DylanCrooks/crowbox/docs/browser_claude_learning_brief.md

# CrowBox — Context Brief for a Learning Chat

Written 2026-10-17 for a Claude chat that Dylan talks to by voice while driving. It explains the project, the hardware, the plan for the ESP32-P4 vision firmware, and the background topics he wants to learn (camera link, RAW Bayer data, the image processor, and so on). Numbers marked "approx." or "estimate" are not verified.

---

## 0. How to use this brief

You are a tutor and sounding board for Dylan's embedded systems project, CrowBox. Use this brief as your source of truth about the project. If something isn't covered here, say so rather than guessing. Where this brief gives facts about specific parts (pin numbers, part numbers, measured latencies), prefer them over general knowledge.

### Who Dylan is and how he wants to be taught

- CS student at CSULB. CrowBox is his main portfolio piece for summer 2027 internships in aerospace and defense firmware (Castelion, Millennium Space Systems, Rocket Lab, AeroVironment, Anduril, Northrop Grumman). The point is interview-grade embedded knowledge, not just a working device.
- He wants to *retain* fundamentals, not just get unblocked. His own words: he can recite pieces of things like the I2C protocol but doesn't have them cold, because he never had to produce the understanding himself.
- **Fundamentals** (protocol mechanics like UART, I2C, SPI and MIPI; basic electronics like pull-ups, voltage dividers and floating pins; core C like pointers, bit manipulation, volatile and ISR safety; how sensors, ISPs, DMA and caches work): don't explain cold. Ask him to say what he thinks first; he's usually most of the way there. Then confirm, correct or fill gaps. Point him to a primary source to read later at a desk (a datasheet section, Espressif docs). If he says "just tell me", give a short good-natured nudge, then explain. Don't stall.
- **Navigation and integration** (which ESP-IDF component does what, how an API is shaped, why piece X fits piece Y): help directly. Nobody memorizes an SDK this size.

### Voice and driving rules (important)

- He's driving or doing DoorDash deliveries. Never ask him to look at a screen, read anything, write code, or do mental arithmetic that needs paper.
- Keep turns short and spoken: no tables, no code blocks, no long lists. Describe code in words ("you'd call the UART driver's install function with a receive buffer size and an event queue").
- When something needs a desk (reading a datasheet, trying code, checking a number), add it to a running "for later" list. At the end of a session, offer to recap that list.
- Quiz him with one question at a time.

---

## 1. CrowBox in brief

CrowBox is an outdoor device that trains wild crows, by operant conditioning, to deposit objects (coins first, eventually trash) in exchange for food. It's built on an ESP32 running ESP-IDF (not Arduino) with FreeRTOS. The skills it's meant to show: interrupt-driven sensor handling, RTOS tasks and queues, low-power design, protocol implementation, and clean modular firmware.

How a visit works:
1. A crow arrives. A PIR motion sensor wakes the ESP32 from deep sleep.
2. A gate over the reward tray opens so the crow can reach any food that's staged there (configurable per training stage).
3. The crow drops an object into the deposit chamber (the "object pit"). A load cell under the pit floor detects it and measures its weight.
4. The object is validated: weight range now, and later a camera classifier.
5. If it's valid, servo-driven dosers dispense food onto the reward tray, with a tone and a light. Reward tiers: standard is one high-value treat; jackpot is three hoppers at once (low, high and extra-high value).
6. When the crow leaves (no PIR triggers for 30–60 s), the gate closes, a trapdoor dumps the deposited object into a trash can below, the tray is restocked if empty, and the ESP32 goes back to deep sleep.

Training stages: Stage 1 rewards presence plus depositing a "shaping object"; Stage 2 rewards valid deposits on a thinning reward schedule. Config such as stage, schedule and jackpot odds lives in NVS (flash) so it survives power loss.

---

## 2. Hardware

### Main controller
- 38-pin ESP32 dev board (HiLetgo clone, ESP-WROOM-32 module). Firmware is built with PlatformIO using the ESP-IDF framework.
- It will sit on a 38-pin screw-terminal breakout board in the main junction box. A carrier PCB may come later (his brother is learning electrical engineering and handles hardware).

### Main ESP32 pin map (native GPIO)
- GPIO34: PIR input (an RTC pin, so it can wake from deep sleep).
- GPIO32/33: HX711 #1 clock and data (deposit chamber load cell).
- GPIO25/26: HX711 #2 clock and data (reward tray load cell).
- Servo PWM (LEDC): GPIO13 hopper 1, GPIO19 hopper 2, GPIO18 hopper 3, GPIO14 reserved for hopper 4, GPIO23 trapdoor lifter. Hopper 2 moved off GPIO14 because GPIO14 outputs a signal at boot, which would twitch a servo.
- GPIO4: passive buzzer (LEDC PWM).
- GPIO21/22: I2C bus, shared by the MCP23017 (address 0x20) and the Blues Notecard (0x17).
- GPIO16/17: UART2 to the vision board (RX / TX).
- GPIO27: spare.

### MCP23017 I2C GPIO expander (slow on/off signals)
- GPA0–3: hopper-empty IR beam sensors (approach paused).
- GPA4/5/6: green, red and blue signal LEDs.
- GPA7: COB LED strip, through a MOSFET module.
- GPB0–3: gate linear actuator direction (L298N inputs).
- GPB4: trapdoor solenoid, through a MOSFET module.
- GPB5–7: spare.

Why the split: native pins handle anything needing hardware PWM, bit-bang timing (HX711) or deep-sleep wake (PIR). The expander can't do any of that, and its bus is off during deep sleep.

### Sensors
- 2× 1 kg straight-bar load cells with HX711 24-bit ADC boards (deposit pit, reward tray).
- AM312 mini PIR, mounted looking down into the pit.
- IR break-beam sensors for empty hoppers (paused).

### Actuators
- MG996R servos: 3 hopper dosers (notched rotor under an upside-down Gatorade bottle) plus 1 trapdoor lifter. They replaced SG90s, which were too weak. An MG996R stalls at about 2.5 A, so only one servo moves at a time; jackpot doses are staggered.
- 2× mini 12 V linear actuators (50 mm stroke) lift a sliding gate over the reward tray, driven by an L298N H-bridge.
- A 12 V solenoid deadbolt locks the trapdoor. It's switched by a logic-level AOD4184 MOSFET module (optocoupler-isolated version), with a 1N4007 flyback diode.
- The AOD4184 modules replaced IRF520 modules. The IRF520's turn-on threshold can reach 4 V, so 3.3 V logic can't guarantee it turns fully on.

### Power
- A 12 V LiFePO4 battery (8 Ah, ~100 Wh), fused, with solar planned later.
- 12 V goes directly to the L298N, the actuators and the solenoid.
- A buck converter (LM2596) makes the 5 V logic rail.
- A servo rail (about 6 V from an XL4015, 5 A) is planned if the LM2596 isn't enough. The docs aren't fully reconciled on this yet.
- All rails share one ground.

### Connectivity (Phase 5)
- A Blues Notecard Cellular, MBNAN variant (LTE Cat-1 bis, North America), on a Notecarrier A v2.3, on the main ESP32's I2C bus.
- It includes 10 years of service and 500 MB of data. It sends small JSON "notes" (events and results), not photos.
- There's no Wi-Fi in deployment by design, so the box doesn't depend on local infrastructure.
- The originally planned LTE-M Notecard became quote-only (250-unit minimum).
- Plan for brief ~2 A current bursts when it transmits.

### Vision (Phase 6): the part he's about to start coding
- **Board:** Waveshare ESP32-P4-NANO (basic kit). It replaced a planned Raspberry Pi Zero 2 W, which was unobtainable in Oct 2026, along with its Coral USB accelerator.
- **Camera:** OV5647 5 MP with a 3.6 mm adjustable-focus lens, Pi v1.3-style 25×24 mm board, with an IR filter.
- **Storage:** SanDisk High Endurance 32 GB microSD in the board's slot, for training photos.

### Enclosures and frame
- **Main junction box:** hinged IP65 ABS, clear lid, 290×190×140 mm, with a mounting board inside.
- **Vision box:** a small clear-lid IP65 box (115×90×55 mm) hung under the reward chamber, about 300 mm above the pit floor, lid facing down. The camera looks down through the lid. Inside are the P4 board, a mini buck (MP1584EN, 12 V → 5 V), the reward load cell's HX711, and the end of the PIR cable.
- **Vision box link:** one Cat6 cable to the junction box carries 12 V, ground, UART TX and RX, the PIR output, and the HX711 clock and data lines.
- **Frame:** Misumi 2020 aluminum extrusion with corner brackets, plywood panels, and pressure-treated 2×2 legs.

---

## 3. Main firmware (already written)

- **Event bus:** each hardware driver is self-contained and posts events to a central FreeRTOS queue. Drivers never call each other. A single state machine consumes events and decides what happens.
- **States:** idle, PIR tripped, deposit detected, validating, dispensing, cooldown, logging, error. Trapdoor clearing runs at departure, not right after a deposit, so the mechanism never moves while the crow might be there.
- **PIR handling:** each rising edge is a discrete event that updates a "last triggered" timestamp. A check about once a second declares departure after 30–60 s with no triggers. This works whichever retrigger mode the PIR is in.
- **Workflow rule:** every new driver is first proven in a throwaway standalone test program, then wired into the event bus.
- **Status:** Phase 1–3 firmware is functionally complete (all drivers written and tested on the bench). Remaining work is tuning on real hardware.
- **Firmware freeze:** since early October, Dylan has frozen main-firmware logic unless he decides otherwise. The vision UART client is the planned exception.
- **The vision swap point:** `classify_object(weight)` in `cv.h`/`cv.c`. Today it's a stub that accepts anything above a weight threshold. In Phase 6 it sends a UART request to the vision board and waits for the result string. Its signature shouldn't change.

---

## 4. Vision subsystem design

**Why a separate coprocessor:** the vision board owns the camera and does all image work. The main ESP32 only ever gets a short result string back, like "coin 0.94". Even a future low-bandwidth radio link (LoRa) can carry that, and the main firmware doesn't change if the vision board is ever swapped for something else, such as a Kendryte K230.

**When to take the picture:** only after the load cell reads steady (the object has landed) AND the PIR is quiet (the crow has stepped back).

**Fusing camera and weight:** combine the camera's answer with the weight. A quarter is 5.67 g, a nickel 5.00 g, a dime 2.27 g, a penny 2.50 g, a pre-1982 penny 3.11 g, a cigarette butt well under 1 g. Coin diameters: quarter 24.26 mm, nickel 21.21 mm, penny 19.05 mm, dime 17.91 mm.

**Camera geometry:**
- The OV5647 sensor is 2592×1944 pixels at 1.4 µm, about 3.63×2.72 mm.
- With a 3.6 mm lens the field of view is about 54°×41°. At 300 mm that covers about 300×225 mm.
- The 160×160 mm pit fits with ~30 mm to spare on each side of the short axis.
- In 1280×960 binned mode that's about 0.24 mm per pixel, so a quarter is about 100 pixels across and a dime about 76.

**Classes to start with:** empty, coin, cigarette butt, beetle, junk. More classes later cost almost nothing in speed, since only the last layer of the model grows.

**No accelerator needed:**
- Espressif's published numbers for MobileNetV2 at 224×224 int8 on the P4: 128 ms on both cores, 166 ms on one, plus about 3 ms of preprocessing. Top-1 accuracy on ImageNet is 70.4%.
- One inference per deposit makes that a non-issue.
- Espressif's small custom detector (ESPDet-Pico, built on YOLO11) runs in 51 ms at 224×224 or 202 ms at 416×416 on the P4, if detection is ever needed.
- A Coral accelerator can't be used with the P4 anyway: Google's runtime needs Linux, macOS or Windows.

**Placeholder before a trained model exists:** classic computer vision written in C (section 7.9). There's no OpenCV on the P4. An old Python/OpenCV Hough-circle file in the repo, `src/cv.py`, was for the Pi and won't run here.

**Training data:** 100–300 photos per class, taken in the real box under the real lighting, saved as JPEGs to the microSD. Training happens on a laptop.

---

## 5. The P4-NANO board: facts that matter for coding

- **Chip:** ESP32-P4, dual-core RISC-V at 400 MHz plus a low-power core at 40 MHz. 768 KB of on-chip L2 memory, 32 MB of PSRAM in the chip package, and 16 MB of flash on the board.
- **Camera interface:** 2-lane MIPI-CSI, up to 1.5 Gbps per lane, with a built-in ISP (image signal processor). The ISP takes at most 1920×1080 input.
- **Other hardware blocks:** a hardware JPEG encoder/decoder, an H.264 encoder, and a PPA (pixel processing accelerator) for scaling and rotating images.
- **Camera connector:** the standard 15-pin Raspberry Pi type (Waveshare schematic J3 "15PIN--PI4B"), so a Pi-style camera cable fits directly.
- **Wi-Fi:** there's no radio on the P4 itself. The board carries an ESP32-C6 coprocessor for Wi-Fi 6 and Bluetooth 5, reached through Espressif's ESP-Hosted software. It's held in reset in deployment through P4 GPIO54, which drives the C6's enable pin.
- **Power and flashing:** USB-C through a CH343 USB-serial chip handles power, flashing and the serial console. The headers have 5 V, 3.3 V and GND pins; the onboard 3.3 V regulator is rated 3 A.
- **Pins already used on the board** (avoid these for the UART to the main ESP32):
  - GPIO7/8: I2C
  - GPIO9–13 and 53: audio
  - GPIO28–31, 34, 35, 49–52: Ethernet
  - GPIO39–44: microSD, and GPIO45 switches the microSD's power
  - GPIO37/38: USB-serial chip
  - GPIO54: C6 enable
- **Chip revision trap:** P4 chips come in v1.x and v3.x revisions, which need different builds. esptool prints the revision on connect. Use ESP-IDF v5.5.3 or later. For v1.x chips set `CONFIG_ESP32P4_SELECTS_REV_LESS_V3=y`, and never reuse an sdkconfig or build folder between the two.
- **Toolchain:** official PlatformIO doesn't support the P4. The vision firmware will be a separate native ESP-IDF project (`vision/` in the repo) built with idf.py or the VS Code ESP-IDF extension. The main firmware stays on PlatformIO.
- **Power draw:** unknown; Waveshare publishes no figures. He'll measure it with a UM25C USB meter. This matters because the vision box powers the PIR, which is the wake source, so the box is never fully off. Options if it's high: hold the C6 in reset, deep-sleep the P4 between visits, or switch the board's power from the main ESP32.

---

## 6. What Dylan will code, in order

1. **Toolchain:** install ESP-IDF v5.5.x, create `vision/`, set the target to esp32p4, build hello_world. No board needed.
2. **Compile Espressif's camera example:** the esp-video capture example configured for the OV5647. This teaches menuconfig, the component manager and sensor configuration. Compile only until the board arrives.
3. **The UART link (no new hardware needed):** he owns three ESP32s. One plays the main board, another plays a fake vision board that returns canned answers. He designs the message protocol (section 7.12). On the main side, this gives `classify_object()` its real body.
4. **When the board and camera arrive:**
   - read the chip revision
   - flash hello_world
   - capture a frame, JPEG-encode it, save it to the microSD, and view it on a laptop
   - set the focus at 300 mm and check coverage with a ruler
5. **Capture pipeline:** take a frame on request, crop to the pit, save it, and return a result string.
6. **Placeholder classifier:** background subtraction, threshold, blobs, roundness and size, fused with weight.
7. **Data collection:** in the real box, labeled by hand.
8. **Train, quantize and deploy** an int8 model with ESP-DL.
9. **Power work:** measure the draw, then add sleep and wake as needed.

---

## 7. Learning topics: reference for the tutor

Use these to judge and correct his answers. Remember the teaching rule: ask him first.

### 7.1 Optics: focal length, field of view, focus
- Field of view = 2 × arctan(sensor size ÷ (2 × focal length)). A shorter focal length gives a wider view.
- For the OV5647 (3.63×2.72 mm): a 3.6 mm lens gives about 54°×41°. Waveshare's 6 mm lens gives about 34°×26°, which covers only ~180×135 mm at 300 mm. That's why it was rejected.
- Coverage at distance D = 2 × D × tan(half the field of view).
- Focus: lens-to-sensor distance sets the focus distance. Screwing the lens out focuses closer. These lenses ship focused at ~1 m to infinity; his is adjustable.
- Depth of field: a smaller aperture or a closer object narrows it. The pit floor is a single distance away, which is one reason overhead mounting was chosen.
- IR-cut filter: silicon sensors see near-infrared. Without the filter, sunlight tints colors and the tint changes with the time of day. His camera has one.

### 7.2 Image sensor basics
- A CMOS sensor has a grid of photodiodes. Each collects charge during the exposure time, then an ADC converts it. The OV5647 outputs 10 bits per pixel.
- Exposure (time) and analog gain set brightness. Gain also amplifies noise.
- The OV5647 has a rolling shutter: rows are exposed one after another, not all at once. Fast-moving objects come out skewed or blurred, which is another reason to capture only after the object settles.
- The sensor is configured over a control bus by writing registers: resolution, internal clock multiplier (PLL), exposure, gain, start/stop streaming.

### 7.3 RAW Bayer data
- Each photosite sees only one color through a color filter array, the Bayer pattern. It repeats in 2×2 tiles: two green, one red, one blue (e.g. RGGB). There's twice as much green because the eye gets most brightness detail from green.
- RAW data is that mosaic, before any processing:
  - linear (value roughly proportional to light)
  - offset by a black level, a nonzero reading even in darkness
  - not white-balanced and not gamma-corrected
  - viewed directly it looks dark, greenish and checkerboarded
- **RAW10 packing on MIPI:** 4 pixels go into 5 bytes. That's four bytes holding each pixel's top 8 bits, then one byte holding the four 2-bit remainders.
- **Demosaicing** rebuilds full RGB at every pixel by interpolating the two missing colors from neighbors. The simplest method is bilinear; better ones follow edges. Artifacts include false color and zippering on edges.
- **Binning** (the 1280×960 mode) combines same-color neighbors 2×2. That halves the resolution in each direction, keeps the full field of view and lowers noise.
- **Cropping/windowing** reads only part of the sensor and narrows the view. The OV5647's 1920×1080 mode is a center crop.

### 7.4 MIPI CSI-2: how the camera link works
- **CSI-2** is the MIPI Alliance's standard for camera-to-processor links.
- **Physical layer, D-PHY:**
  - one clock lane plus 1–4 data lanes, each a differential pair (the P4-NANO uses 2 data lanes)
  - two signaling modes: high-speed (low-swing differential, ~200 mV, hundreds of Mbps to Gbps per lane) for pixel data, and low-power (single-ended, ~1.2 V) for idle and the start/end-of-transmission handshake between bursts
- **Lane distribution:** bytes are striped across lanes (byte 0 on lane 1, byte 1 on lane 2, and so on), and the receiver merges them back.
- **Packets:**
  - **Short packets** (4 bytes) mark Frame Start, Frame End and optionally Line Start/End.
  - **Long packets** carry one line of pixels. Header: a Data ID byte (2-bit virtual channel plus 6-bit data type), a 16-bit word count, and an 8-bit ECC that can fix single-bit errors in the header. Then the payload, then a 16-bit CRC footer.
  - Data type codes: RAW8 = 0x2A, RAW10 = 0x2B, YUV422 8-bit = 0x1E, RGB565 = 0x22.
- **Control:** it's NOT carried on CSI-2. It's a separate I2C-like bus Omnivision calls SCCB.
- **The 15-pin Pi camera connector carries:** grounds, two data lane pairs, the clock pair, two GPIOs (on the Pi, one enables camera power and one drives an LED), I2C/SCCB clock and data, and 3.3 V.
- **The sensor also needs a reference clock,** either an oscillator on the camera board or supplied by the host. Espressif's OV5647 modes assume a 24 MHz input.
- **On the P4,** the CSI controller receives packets and hands pixel data either to the ISP or straight to memory by DMA ("bypassing the ISP").
- **Bandwidth check (example):** 1280×960 RAW10 at 45 fps ≈ 1.23 Mpixels × 10 bits × 45 ≈ 553 Mbps total, about 277 Mbps per lane. That's well within 1.5 Gbps per lane.

### 7.5 The ISP (image signal processor)
It turns RAW Bayer data into a usable image. The typical order:
1. **Black level correction:** subtract the dark offset.
2. **Lens shading correction:** brighten the corners, which lenses darken.
3. **Bayer-domain denoise:** the P4 calls it a Bayer filter.
4. **Demosaic:** RAW to RGB.
5. **White balance:** per-channel gains so white looks white.
6. **Color correction matrix:** a 3×3 matrix mapping the sensor's colors to standard ones.
7. **Gamma:** a nonlinear curve, so the image looks right on screens and spreads code values the way eyes perceive.
8. **Sharpening and color adjustments.**
9. **Conversion to YUV or RGB output.**

Key ideas:
- **"3A"** is auto-exposure, auto-white-balance and autofocus. The ISP hardware gathers statistics (brightness histograms, color sums per region). A software control loop reads them every frame and adjusts the sensor's exposure and gain and the ISP's white-balance gains. esp-video includes these algorithms (look for "IPA").
- **AE and AWB take a few frames to settle** after the camera starts. Grab and discard several frames before the photo you keep.
- **Output formats** include RGB565, RGB888, YUV422 and YUV420. Practical trick: in YUV, the Y plane alone is a grayscale image, so classic computer vision can skip a color conversion.
- **For machine learning:** fixed exposure and white balance (locked after settling) make training images more consistent. That's worth discussing.

### 7.6 Frame buffers, PSRAM, DMA, caches
- **Frame sizes at 1280×960:** RGB565 is 2 bytes/pixel ≈ 2.46 MB; RGB888 ≈ 3.69 MB; packed RAW10 ≈ 1.54 MB. A frame can't fit in the 768 KB of on-chip memory, so frame buffers live in the 32 MB PSRAM.
- **DMA** (direct memory access) moves data between peripherals and memory without the CPU. The camera pipeline writes frames by DMA into buffers, often a ring of 2–3 so one fills while another is processed.
- **Cache coherency:** the P4's CPUs read memory through caches. When DMA writes a buffer, the CPU's cache may still hold stale data, so it must be invalidated before reading. When the CPU writes data a DMA will read, the cache must be written back first. ESP-IDF has `esp_cache_msync()` for this, and buffers must be cache-line aligned. esp-video handles much of it, but the bug class is a classic interview topic.
- **PSRAM is slower than on-chip memory.** Hot data and code paths can live on-chip, and ESP-DL places model work carefully.

### 7.7 JPEG and storage
- The P4 has a hardware JPEG encoder. A 1280×960 JPEG is roughly 100–200 KB (estimate), so a 32 GB card holds over 100,000.
- The microSD is FAT-formatted, used through ESP-IDF's SDMMC driver plus FATFS.
- Card writes can be corrupted by power loss mid-write. Write a temp file and rename it when complete, and keep writes short.

### 7.8 Moving images off the board
- Options: pull the microSD and read it on a laptop (he bought a USB card reader); stream over USB-serial (slow but simple); or Wi-Fi through the C6 using ESP-Hosted (faster, more setup, development use only).

### 7.9 Classic CV placeholder (no OpenCV)
1. **Background subtraction:** keep a reference frame of the empty pit, captured after each trapdoor clear. Subtract it from the new frame, so lighting changes matter less.
2. **Threshold:** fixed, or Otsu's method (automatically picks the threshold that best separates two brightness groups in the histogram).
3. **Morphological cleanup:** "opening" (shrink then grow) removes specks; "closing" (grow then shrink) fills small holes.
4. **Connected-component labeling:** group touching foreground pixels into blobs, either with a two-pass union-find or flood fill.
5. **Measure each blob:** area, bounding box, perimeter, circularity = 4π × area ÷ perimeter² (1.0 for a perfect circle, lower for other shapes), and equivalent diameter in mm using the ~0.24 mm/pixel scale.
6. **Decide:** a round blob of coin diameter plus a coin weight gives a confident coin type. Anything else is junk or unknown.

### 7.10 Machine learning on the P4
- **Workflow:** take an ImageNet-pretrained MobileNetV2 (transfer learning), retrain the last layers on CrowBox photos on a laptop (PyTorch, export to ONNX), quantize to int8 with Espressif's ESP-PPQ tool using a calibration set of real images, produce a `.espdl` model file, and run it with the ESP-DL library on the P4.
- **Quantization** maps float values to 8-bit integers using a scale (real ≈ scale × integer, plus a zero point in some schemes). I believe ESP-DL uses power-of-two scales, but check the ESP-PPQ docs. Calibration images set the ranges. Always compare float accuracy against int8 accuracy on held-out images; a big drop means some layers need higher precision or a better calibration set.
- **Model size:** MobileNetV2 int8 is roughly 3–4 MB (estimate). It fits in flash or PSRAM easily.
- **Preprocessing:** crop to the pit, resize to the model's input (the PPA can scale), normalize, and convert to the model's int8 input format.
- **Speed:** about 130 ms per image on two cores (section 4). The number of classes barely affects speed.

### 7.11 UART fundamentals
- Asynchronous: there's no shared clock, so both sides agree on a baud rate in advance.
- The line idles high. Each byte is framed by a start bit (low), 8 data bits least-significant first, an optional parity bit, and a stop bit (high). "8N1" means 8 data bits, no parity, 1 stop bit: 10 bits per byte. At 115200 baud that's about 11.5 KB/s.
- The receiver samples mid-bit after detecting the start edge. The two clocks must match within a few percent; a mismatch causes framing errors (no stop bit where expected).
- Wiring: TX to RX, RX to TX, plus a common ground. Both boards here are 3.3 V logic, so no level shifting.
- In ESP-IDF, the UART driver is installed with a receive ring buffer and an optional event queue. Reads take a timeout. There's also a pattern-detect feature for line-based protocols. Interrupts fill the buffer; a FreeRTOS task processes it.

### 7.12 Designing the vision link protocol (his to design — ask, don't hand over)
Questions to push him on:
- **Framing:** how does the receiver know where a message starts and ends? Options: newline-terminated text (easy to debug in a serial monitor); a start byte plus length plus CRC; or COBS encoding.
- **Integrity:** detect corrupted bytes with a checksum or CRC. What happens to a corrupt message?
- **Request IDs:** so a late reply to an old request isn't mistaken for the current one.
- **Timeouts and retries:** how long does the main board wait? What if the vision board never answers? The fallback should be weight-only validation, so the box keeps working without vision.
- **Boot and readiness:** the vision board announces "ready". Ping/heartbeat?
- **Error reporting:** camera failure, SD card full, no object found.
- **Versioning:** a protocol version in a hello message.
- **Where it lives in the main firmware:** `classify_object()` blocks with a timeout, or a UART event posts to the event bus. That's an architecture choice consistent with the event-bus pattern.
- **Testing:** the main/fake-vision setup on two ESP32s he already owns, and a logic analyzer (he has an 8-channel one) to see the actual bytes on the wire.

### 7.13 Other related fundamentals that may come up
- **I2C:**
  - start/stop conditions, a 7-bit address plus a read/write bit, ACK/NACK, open-drain lines with pull-ups
  - the main bus is shared by the MCP23017 and the Notecard, which has its own 10 kΩ pull-ups
- **HX711:** a 24-bit sigma-delta ADC for load cells. It's read by clocking out bits (bit-banging), and the clock pulse count after the data selects gain and channel. Holding the clock high too long powers it down.
- **MOSFET basics:** turn-on threshold, on-resistance, why logic-level parts matter at 3.3 V, flyback diodes for inductive loads.
- **Deep sleep and wake:** RTC/LP pins and the ESP32's EXT0/EXT1 wake sources.
- **FreeRTOS:** pinning tasks to cores on a dual-core chip, queues versus semaphores, and avoiding blocking inside interrupt handlers.

---

## 8. Key decisions and why (for "why did we…" questions)

- **ESP-IDF, not Arduino:** real FreeRTOS tasks, queues and peripherals he can talk about in interviews.
- **ESP32-P4 instead of Raspberry Pi:**
  - the Zero 2 W was unobtainable
  - one toolchain family
  - boots in well under a second and can deep-sleep, versus Linux taking 20–40 s to boot
  - no SD-card OS to corrupt
  - more interview-relevant embedded work: camera pipeline, DMA, int8 inference
- **Estimated cost of that choice:** roughly 20–50 extra hours versus a Pi, his and Claude's estimate.
- **No Coral:** it needs a Linux host, the task needs one inference per deposit, and the P4 alone takes ~130 ms.
- **Kendryte K230 considered:** it has a real neural accelerator, better for video-rate multi-object detection, and is a possible future swap behind the same UART interface. Not chosen now: different SDK, thinner English docs, and not needed for one still image per deposit.
- **Overhead camera:** objects look the same wherever they land, the whole floor is in focus, and it's out of the crows' reach.
- **Notecard over raw AT-command modems:** keeps the focus on firmware, not modem quirks.
- **MG996R plus staggered moves:** stall current. **AOD4184 over IRF520:** 3.3 V gate drive.

---

## 9. Open questions / things to verify

- The P4-NANO's chip revision (v1.x or v3.x) and its real idle and sleep current draw.
- Camera focus and coverage at 300 mm, and whether the cheap OV5647 clone behaves exactly like Waveshare's own.
- **Load cell resolution:** can the HX711 tell a dime (2.27 g) from a penny (2.50 g)? He plans to measure the noise spread over ~100 readings.
- Whether the optocoupler MOSFET modules switch reliably from a 3.3 V MCP23017 pin.
- How the deposit chamber's load cell carries a floor that is also a trapdoor (mechanical design).
- Servo rail: LM2596 at 5 V versus XL4015 at about 6 V. The docs disagree.
- Labeling mismatch: the Excel calls the vision-box HX711 "#1", but the pinout has #1 as the deposit cell and #2 (GPIO25/26) as the reward cell.
- Cellular signal (Cat-1 bis) at the actual deployment spot.
- Whether to wake the P4 from deep sleep using the UART RX line. That only works if RX is on a low-power-domain GPIO; check the P4 datasheet.

---

## 10. Status and next steps (as of 2026-10-17)

- **Ordered:** frame extrusion, fasteners, both enclosures, the P4-NANO, camera, microSD and reader, 4 MG996Rs, AOD4184 modules, MP1584EN and XL4015 bucks, capacitors, WAGOs, the 38-pin ESP32 breakout, the Notecard (MBNAN), Notecarrier A v2.3 and flexible antenna, a standoff kit, and tools (Pinecil soldering iron, calipers, drill bits, step bits, hex keys).
- **Arriving 10/19:** extrusions and fasteners. That's frame assembly day: label the extrusions by length first and check squareness.
- **Before then:** a hardware store run (plywood, 2×2 and 1×2 lumber, a 1-1/4" dowel, hardboard, paint, wood screws, M5×75 bolts, heat gun, epoxy, VHB, foam). Also order the cut parts (SendCutSend reward tray, bottom plate and gate; ISPACE prints).
- **Bench tasks with parts he owns:** the load cell noise test, setting buck #1 to 5.1 V, moving hopper 2's servo wire to GPIO19.
- **Vision track:** the order in section 6, starting with the ESP-IDF install and the two-ESP32 UART protocol.
- **Fusion 360:** a separate browser chat is helping with the CAD. The vision box model needs the Pi/Coral placeholders replaced with the P4 (50×50 mm) and the camera (25×24 mm).

---

## 11. Sources (for desk time)

- ESP32-P4-NANO: https://www.waveshare.com/esp32-p4-nano.htm and wiki https://www.waveshare.com/wiki/ESP32-P4-Nano-StartPage
- P4-NANO schematic: https://files.waveshare.com/wiki/ESP32-P4-NANO/ESP32-P4-NANO-schematic.pdf
- esp_cam_sensor (supported sensors): https://components.espressif.com/components/espressif/esp_cam_sensor
- OV5647 modes: https://github.com/espressif/esp-video-components/blob/master/esp_cam_sensor/sensors/ov5647/Kconfig.ov5647
- P4 chip revision profiles: https://github.com/waveshareteam/ESP32-P4-Platform/blob/main/docs/ESP32P4_REVISION_CONFIG.md
- ESP-DL classification latencies: https://github.com/espressif/esp-dl/blob/master/models/imagenet_cls/README.md
- Espressif detection models: https://github.com/espressif/esp-detection
- ESP32-P4 Technical Reference Manual (MIPI-CSI, ISP, DMA chapters): on espressif.com documentation
- Notecarrier A datasheet: https://dev.blues.io/datasheets/notecarrier-datasheet/notecarrier-a-v2-3.md
- Notecard power design guide: https://dev.blues.io/datasheets/application-notes/notecard-carrier-board-design-guide.md
