DylanCrooks/crowbox/CrowBox_PartsList.xlsx

Sheet: Summary
CrowBox - parts list and cost
Model v2_3 + new files (Wiring_v2, FieldModules, JunctionBox_v2, Panels_v3). Prices are estimates in USD, Oct 2026.
How to use
Type Y in the yellow 'Have?' cells (Buy and Tooling tabs) for anything you already own, e.g. Y next to the MG996R servos. 'Still to buy' updates. Blue numbers are inputs you can change; black are formulas; green pull from another tab.
Assumptions
Fastener spare |  | 10% | added before rounding up to packs
Cable spare |  | 10% | on top of route + inside-box + end slack
Print waste |  | 15% | failed prints, supports, purge
Cost by phase
Phase | What | Total $ | Still to buy $
Build | Everything to build and run the box now | $1306.8 | $1306.8
Phase 5 | Cellular (Notecard) | $74 | $74
Phase 7 | Coral accelerator (dropped 2026-10-17) | $68 | $68
Phase 9 | Solar: panel, tilt kit, controller, cable | $138.97 | $138.97
Paused | IR beam pairs | $18 | $18
All parts | Build + later phases + paused | $1605.77 | $1605.77
Tooling (separate) | see Tooling tab | $184 | $184
Options (not in totals) | clear polycarbonate front panel | $160
Option: McMaster brackets | 78 x 5537T935 at ~$5.50 instead of the generic kits | $385 |  | extra cost over the generic kits
Build cost by section
Section |  | Total $ | Still to buy $
Frame |  | $195.8 | $195.8
Fasteners |  | $176 | $176
Wood & sheet |  | $124 | $124
Cut service |  | $94 | $94
Junction box |  | $140 | $140
Vision box |  | $82 | $82
Field modules |  | $160 | $160
Power |  | $68 | $68
Wiring |  | $205 | $205
Filament |  | $44 | $44
Install |  | $18 | $18
Build total (check) |  | $1306.8 | $1306.8
Key quantities
2020 extrusion |  | 35 | bars, from 15 x 1000 mm sticks
Corner brackets |  | 78 | 70 in model + 8 roof
M5 T-nuts (plus kit ones) |  | 150 | plus 2 per bracket in the kits
M5 screws + bolts |  | 152 | 8 / 10 / 12 / 16 / 20 / 25 / 50 / 75 mm - see Fasteners
Cable runs |  | 19 | see Wiring; 13 end at the JB (1 reserved)
Printed parts |  | 17 | see Print
Tabs
Buy | everything to purchase, by section, with 'Have?'
Print | printed parts, material, settings, grams
Cut | SendCutSend parts, wood cut list, 2020 cut list
Fasteners | every screw by size and where it goes
Wiring | 19 cable runs: type, conductors, gland, length
Glands | which cable goes in which gland hole
Tooling | tools, '?' where unsure
Unmodeled | what's not in the model and whether it needs to be
Doc check | electronics doc vs the model
Model fixes | things to fix in Fusion

Sheet: Fasteners
Key (size) | Used on | Qty | Goes into | Why this length (clamped stack -> screw)
M5x8 BHCS | Pit light ring -> pit top bars | 4 | M5 T-nut | ring lip 2.5 + washer 1 = 3.5 -> 8. M5x10 would hit the extrusion core.
M5x8 BHCS | Vision box ears -> reward crossbars (drill ears 4.5 -> 5.5 mm) | 4 | M5 T-nut | ear 4 -> 8
M5x10 BHCS | Bottom plate -> vision crossbar (back row) | 6 | M5 T-nut | plate 4.75 (0.187in) -> 10
M5x10 BHCS | Bottom plate -> front bar (X -100, -170, +170) | 3 | M5 T-nut | plate 4.75 -> 10. No shims needed with the 0.187in plate.
M5x10 BHCS | Chute bracket 35 deg -> bars | 4 | M5 T-nut | 5 mm base -> 10. Not M5x12: it bottoms out in the slot.
M5x10 BHCS | Chute -> chute bracket | 4 | M5 hex nut in the bracket's side slots
M5x12 BHCS | Side panels -> posts + side bars (16 per side) | 32 | M5 T-nut | 6 mm ply + washer 1 -> 12
M5x12 BHCS | Back panel -> posts + bars | 20 | M5 T-nut | 6 mm ply + washer 1 -> 12
M5x12 BHCS | Roof plywood -> top bars | 11 | M5 T-nut | 6 mm ply + washer 1 -> 12
M5x12 BHCS | Bay floor -> bars | 13 | M5 T-nut | 6 mm ply + washer 1 -> 12
M5x12 BHCS | Battery shelf -> bottom side bars (new holes) | 4 | M5 T-nut | 6 mm ply + washer 1 -> 12
M5x12 BHCS | PIR housing -> bottom plate -> front bar (no washer) | 2 | M5 T-nut | housing floor 3 + plate 4.75 -> 12
M5x16 BHCS | Front panel through 5 mm standoffs (18 holes minus 4 perch) | 14 | M5 T-nut | 6 ply + 5 spacer + washer 1 -> 16
M5x16 BHCS | Solar tilt-kit feet -> roof -> top bars | 4 | M5 T-nut | 3 foot + 6 ply + washer 1 -> 16
M5x16 BHCS | Signal pod -> plate -> front bar (replaces the M5x10 at X +100) | 1 | M5 T-nut | pod floor 6 + plate 4.75 -> 16
M5x16 BHCS | Junction box top flange -> back panel -> bay back bar | 2 | M5 T-nut | flange 5 + ply 6 + washer 1 -> 16
M5x16 BHCS | Gate actuator rear mounts -> front posts (?) | 2 | M5 T-nut (5278N43 in model) | verify against your actuator mount
M5x20 BHCS | Junction box bottom flange -> back panel (no bar behind) | 2 | M5 nyloc + washers inside | flange 5 + ply 6 + 2 washers + nyloc -> 20
M5x25 flanged BHCS | Perch brackets -> front panel -> front posts | 4 | M5 T-nut | bracket 10 + ply 6 + spacer 5 = 21 -> 25. M5x30 bottoms out.
M5x50 BHCS | Legs -> side panel -> posts (3 per leg) | 12 | M5 T-nut | leg 38 + ply 6 + fender washer 1.5 -> 50
M5x75 hex bolt | Skirt bolts: leg + side panel + corner cleat | 4 | M5 nyloc | 38 + 6 + 19 + 2 fender washers + nyloc -> 75
M5 T-nut | All screws above that go into a slot | 142 | - | sum of the T-nut rows above (brackets have their own in the kits)
M5 T-nut | Pit mechanism mounts (servo mount, solenoid mount) (?) | 8 | - | estimate: your pit design
M5 washer | Under every head on plywood + JB | 104 | - | side 32, back 20, front 14, roof 15, bay 13, shelf 4, JB 6
M5 fender washer | Legs (12) + skirt bolts (2 each) | 20 | - | 5.3 x 20 mm, spreads load on the 2x2
M5 nyloc | JB bottom bolts 2 + skirt bolts 4 | 6 | -
M5 hex nut | Chute -> chute bracket | 4 | - | fits the bracket's side-entry slots
M5 spacer 5mm | Front panel standoffs | 18 | - | unthreaded, 5 mm long, ~10 mm OD
M4x16 BHCS | Reward load cell fixed end (through plate + 5 mm spacer) | 2 | load cell M4 thread | plate 4.75 + spacer 5 -> 16 (6 mm thread engagement)
M4x16 BHCS | Solar charge controller -> battery shelf | 2 | M4 nyloc | controller tab + 6 ply + washers + nut
M4x20 BHCS | Reward tray -> load cell (through 11 mm spacers) | 2 | load cell M4 thread | tray 2 + spacer 11 -> 20 (7 mm engagement)
M4x20 BHCS | Hopper cradles -> bay floor (2 per cradle) | 6 | M4 nyloc | foot 5 + ply 6 + 2 washers + nyloc -> 20
M4 nyloc | Cradles 6 + controller 2 | 8 | -
M4 washer | Load cell 4 + cradles 12 + controller 4 | 20 | -
Spacer M4x11 | Tray -> load cell (McMaster 92871A311) | 2 | - | as modeled
Spacer M4x5 | Load cell fixed end (McMaster 92871A008) | 2 | - | as modeled
#8x2-1/2 wood | Ground aprons + raised front apron -> legs (2 per joint) | 16 | 2x2 | exterior coated; pre-drill
#8x1-1/4 wood | 1x2 diagonals -> legs/aprons (2 per end) | 12 | 2x2 | exterior coated; pre-drill
#6x5/8 wood | Skirt corner cleats (2 per panel per cleat) | 16 | 3/4in cleat
#6x3/4 wood | Perch rod lock screws | 4 | 1-1/4in dowel | through the printed arm into the rod
Brackets: each of the 78 corner brackets also uses 2 x M5x10 (or M5x8 for <=3.5 mm brackets) + 2 T-nuts, included in the bracket kits on the Buy tab.
Length rule for 2020 drop-in T-nuts: screw length = clamped thickness + 4 to 6 mm. Longer screws hit the extrusion core before they clamp.

Sheet: Wiring
ID | Run | From | To | Buy as | Type key | Cond. | AWG | OD mm | Gland / hole | Route in model (mm) | Inside box (mm) | End slack (mm) | Buy length (m) | Conductor map | Notes
W01 | Doser servo 1 | MG996R on cradle 1 | JB G1 (upper-right hole) | 3-core 22 AWG round | 3C22 | 3 | 22 | 4.2 | G1-UR | 740 | 250 | 150 | 1.3 | Black/brown GND -> GND bus; red +6 V servo rail; white/orange PWM -> ESP32 GPIO | Servo plug mates with a 3-pin 2.54 mm male header soldered to the cable end; heat-shrink + zip tie. Down through the left bay-floor hole.
W02 | Doser servo 2 | MG996R on cradle 2 | JB G1 (lower-right) | 3-core 22 AWG round | 3C22 | 3 | 22 | 4.2 | G1-LR | 598 | 250 | 150 | 1.1 | as W01 | Left bay-floor hole.
W03 | Doser servo 3 | MG996R on cradle 3 | JB G3 (upper-left) | 3-core 22 AWG round | 3C22 | 3 | 22 | 4.2 | G3-UL | 602 | 250 | 150 | 1.2 | as W01 | Right bay-floor hole.
W04 | IR beam pairs x3 (PAUSED) | Bay floor, behind cradle 2 | JB G1 (upper-left) | 6-core 24 AWG round | 6C24 | 6 | 24 | 4.8 | G1-UL | 460 | 250 | 600 | 1.5 | +5 V, GND, OUT1, OUT2, OUT3 -> MCP23017 inputs, 1 spare | Paused: buy later. One shared cable instead of 3. 600 mm end slack = branches to the 3 hoppers. Plug the gland hole until then.
W05 | Gate actuator L | Actuator L (bottom end) | JB G1 (lower-left) | 2-core 20 AWG round | 2C20 | 2 | 20 | 4.3 | G1-LL | 743 | 250 | 150 | 1.3 | Red/black -> L298N OUT1/OUT2 | Butt-splice to the actuator leads with adhesive heat-shrink.
W06 | Gate actuator R | Actuator R (bottom end) | JB G3 (lower-right) | 2-core 20 AWG round | 2C20 | 2 | 20 | 4.3 | G3-LR | 733 | 250 | 150 | 1.3 | Red/black -> L298N OUT3/OUT4 | as W05
W07 | Signal pod (3 LEDs + buzzer) | Signal pod behind PIR slot | JB G3 (lower-left) | 6-core 24 AWG round | 6C24 | 6 | 24 | 4.8 | G3-LL | 602 | 250 | 150 | 1.2 | LED green, LED red, LED blue (330 ohm each, resistors in the JB) -> MCP23017; BUZ -> ESP32 PWM pin; +5 V; GND | Drops down the gap behind the front panel, runs back under the front bar at Z 248.
W08 | Vision box link | Vision box (PG9, back wall) | JB G4 | Cat6 stranded patch cable (8 x 24 AWG) | CAT6 | 8 | 24 | 6 | G4 | 287 | 350 | 100 | 0.9 | Orange +12 V; wht/org GND; green ESP32 TX -> P4 RX; wht/grn P4 TX -> ESP32 RX; blue PIR out; wht/blu GND; brown HX711 SCK; wht/brn HX711 DOUT | 12 V (not 5 V) goes over the cable; a mini buck in the vision box makes 5 V for the ESP32-P4 board and the PIR. The reward HX711 runs off the P4 board's 3.3 V pin. 8 conductors are enough. Cut both RJ45 plugs off.
W09 | Trapdoor servo | MG996R in pit servo mount | JB G2 (lower-left) | 3-core 22 AWG round | 3C22 | 3 | 22 | 4.2 | G2-LL | 1051 | 250 | 150 | 1.6 | as W01 | Up the back-left corner through the battery-shelf notch.
W10 | Pit load cell | Pit load cell (on the trapdoor) | HX711 #2 in JB, G2 (upper-left) | 4-core 24 AWG shielded (foil + drain) | 4C24S | 4 | 24 | 4.6 | G2-UL | 1174 | 250 | 250 | 1.9 | Red E+, black E-, green A+, white A- (match the cell's colors); drain -> HX711 GND at the JB end only | Leave a 10 cm service loop where it leaves the moving trapdoor (included in the 250 mm end slack). Shielded because it runs next to the solenoid and servo leads.
W11 | Trapdoor solenoid | Solenoid (+X end) | JB G2 (lower-right) | 2-core 20 AWG round | 2C20 | 2 | 20 | 4.3 | G2-LR | 1093 | 250 | 150 | 1.7 | Red +12 V; black -> MOSFET module OUT- | 1N4007 across the coil (band to +), at the solenoid.
W12 | Pit light ring | COB strip on the light ring (through lining hole) | JB G2 (upper-right) | 2-core 20 AWG round | 2C20 | 2 | 20 | 4.3 | G2-UR | 971 | 250 | 150 | 1.6 | Red +12 V; black -> MOSFET module OUT- | 12 V COB strip, ~45 cm.
W13 | 12 V power in | Solar controller LOAD (or fuse 1 until Phase 9) | JB G5 -> main switch -> fuse 2 -> WAGO | 2-core 16 AWG round | 2C16 | 2 | 16 | 7 | G5 | 713 | 250 | 150 | 1.3 | +12 V / GND | PG9 takes 4-8 mm cable: pick a 16/2 with OD <= 7.5 mm.
W14 | Solar (Phase 9) | Panel leads under the panel (MC4s cut off) | Charge controller PV terminals | 2-core 18 AWG UV-rated outdoor | 2C18UV | 2 | 18 | 6 | Roof PG7 | 869 | 0 | 300 | 1.3 | PV+ / PV- | Splice to the panel's own leads under the panel with adhesive heat-shrink. Down the back-right corner through the right bay-floor hole.
W15 | Battery + to fuse 1 | Battery + (F2 spade) | Fuse 1 holder (7.5 A) | 16 AWG red | 16AWG | 1 | 16 | 3.2 | - | 68 | 0 | 100 | 0.2 | + | Fuse holder leads usually cover this.
W15b | Fuse 1 to controller BAT+ | Fuse 1 holder | Controller BAT+ | 16 AWG red | 16AWG | 1 | 16 | 3.2 | - | 122 | 0 | 100 | 0.3 | + | Until Phase 9: fuse 1 feeds W13 directly.
W16 | Battery - to controller BAT- | Battery - (F2 spade) | Controller BAT- | 16 AWG black | 16AWG | 1 | 16 | 3.2 | - | 167 | 0 | 100 | 0.3 | -
W17 | PIR | AM312 header (back of PIR housing) | Vision box PG7 #1 (front) | 3-core 22 AWG round | 3C22 | 3 | 22 | 4.2 | VB PG7-1 | 81 | 100 | 100 | 0.4 | VCC (+5 V from vision-box buck), GND, OUT | Through the bottom plate's 8 mm hole at (0, -80). Dupont 3-pin housing at the PIR.
W18 | Reward load cell | Load cell fixed end | HX711 #1 in vision box, PG7 #2 (front) | cell's own 4 leads in heat-shrink | STOCK | 4 | 30 | 3.5 | VB PG7-2 | 111 | 100 | 50 | 0.3 | Red E+, black E-, green A+, white A- | Stock leads (~20 cm) just reach; extend with 4-core shielded leftovers if short. Through the plate's 8 mm hole at (-75, -60).
Buy length = (route + inside-box run + end slack) x (1 + cable spare on Summary), rounded up to 0.1 m. Route lengths are measured along the modeled tubes in CrowBox_Wiring_v2.step.
Totals by cable type
 |  |  |  | Type key | Buy as | Total (m)
 |  |  |  | 3C22 | 3-core 22 AWG round | 5.6
 |  |  |  | 2C20 | 2-core 20 AWG round | 5.9
 |  |  |  | 6C24 | 6-core 24 AWG round | 1.2
 |  |  |  | 4C24S | 4-core 24 AWG shielded | 1.9
 |  |  |  | CAT6 | Cat6 stranded patch | 0.9
 |  |  |  | 2C16 | 2-core 16 AWG round | 1.3
 |  |  |  | 2C18UV | 2-core 18 AWG UV (solar) | 1.3
 |  |  |  | 16AWG | 16 AWG red/black | 0.8
 |  |  |  | 6C24 (W04) | 6-core for the paused IR run | 1.5

Sheet: Glands
Where | Gland | Hole / insert position | Cable | Position (model, mm) | Drill | Notes
Junction box back face | G1 PG16, 4-hole insert (4 x 5 mm) | upper-left | W04 IR beams (PAUSED - plug it) | X -41, Z 360 | 22.5-23 mm | All JB glands sit in one low row so the mounting plate keeps the top 2/3 of the box.
 |  | upper-right | W01 doser servo 1
 |  | lower-left | W05 gate actuator L
 |  | lower-right | W02 doser servo 2
Junction box back face | G2 PG16, 4-hole insert (4 x 5 mm) | upper-left | W10 pit load cell (shielded) | X -5, Z 360 | 22.5-23 mm
 |  | upper-right | W12 pit light ring
 |  | lower-left | W09 trapdoor servo
 |  | lower-right | W11 solenoid
Junction box back face | G3 PG16, 4-hole insert (4 x 5 mm) | upper-left | W03 doser servo 3 | X 31, Z 360 | 22.5-23 mm
 |  | upper-right | spare (plug it)
 |  | lower-left | W07 signal pod
 |  | lower-right | W06 gate actuator R
Junction box back face | G4 PG9 (4-8 mm) | single | W08 vision box Cat6 | X -23, Z 395 | 15.5 mm
Junction box back face | G5 PG9 (4-8 mm) | single | W13 12 V power in | X 13, Z 395 | 15.5 mm | 16/2 cable must be <= 7.5 mm OD.
Back panel | gland window 106 x 65, r6 corners | - | all of the above | X -58..48, Z 343..408 | jigsaw | Replaces the four separate 34/26 mm holes (they would leave 2 mm webs). Run a bead of neutral-cure silicone around the JB back face.
Vision box front wall | PG7 #1 | single | W17 PIR | X +12, Z 262 | 12.5-13 mm | Drill the base walls, never the lid.
Vision box front wall | PG7 #2 | single | W18 reward load cell leads | X -12, Z 262 | 12.5-13 mm | 4 thin leads: slide a heat-shrink sleeve over them so the seal grips.
Vision box back wall | PG9 | single | W08 Cat6 | X -25, Z 258 | 15.5 mm
Roof | PG7 (already modeled) | single | W14 solar | X 205, Y 250 | 12.5-13 mm | Phase 9.
Bay floor, back-left | 16 mm hole (no grommet) | - | W01, W02, W04 | X -208, Y 250 | 16 mm | Rubber grommets don't fit 6 mm ply; sand the edge and wrap the cables with split loom at the hole.
Bay floor, back-right | 16 mm hole (no grommet) | - | W03, W14 | X 208, Y 250 | 16 mm
Bottom plate | 8 mm holes (already modeled) | - | W17 at (0,-80), W18 at (-75,-60) |  | 8 mm | Deburr; heat-shrink sleeve on the cable where it passes.
Battery shelf notches | back-left / back-right | - | left: W09, W10 right: W11, W12 |  | - | Pit cables go under the shelf and rise through the corner notches.
Multi-hole inserts seal 4.5-5.5 mm cable. Build up thinner cable (the 4.2 mm servo cable) with one layer of heat-shrink where it passes the seal. Plug unused holes with a 5 mm rod or a short M5 screw.

Sheet: Print
Part | Source | Qty | Material | Color | Solid vol each (cm3) | Density (g/cm3) | Fill factor | Grams (all) | Size (mm) | How to print | Status | Notes
Signal pod (LEDs + buzzer) | CrowBox_SignalPod_print.step (new) | 1 | ASA | black | 25.1 | 1.07 | 0.85 | 22.82845 | 58 x 53 x 22 | Stand it on the nose tip (front face down): LED bores vertical, no supports. 3 walls, 30%. | Modeled (new) | Nose sits in the PIR slot, so it gets sun: ASA.
Perch bracket L | CrowBox_Perch_D.step | 1 | ASA | any | 219.3 | 1.07 | 0.55 | 129.05805 | 46 x 139 x 165 | On its outer side face so the rod holes print vertical. 4 walls, 30% gyroid. | Modeled | Outside, in the sun, carries the crow: ASA.
Perch bracket R | CrowBox_Perch_D.step | 1 | ASA | any | 219.3 | 1.07 | 0.55 | 129.05805 | 46 x 139 x 165 | as L | Modeled
Chute bracket 35 deg | CrowBox_ChuteBracket_35deg.step | 1 | PETG | any | 67.4 | 1.27 | 0.60 | 51.3588 | 100 x 160 x 116 | Base down. 3 walls, 25%. | Modeled | Inside the box: PETG is fine.
Pit light ring | CrowBox_PitLining_LightRing.step | 1 | PETG | white | 92.6 | 1.27 | 0.60 | 70.5612 | 180 x 180 x 18.5 | Lip down. 3 walls, 20%. | Modeled | White reflects the strip's light into the pit.
PIR housing v2 | CrowBox_PIR_Housing_v2.step (your part) | 1 | PETG | black | 12.3 | 1.27 | 0.90 | 14.0589 | 91 x 30 x 25 | Floor down. | Modeled | Lower it 0.8 mm in the model (it floats above the plate).
Hopper cradle | your Cradle part | 3 | PETG | any | 35.7 | 1.27 | 0.85 | 115.61445 | 93 x 68 x 100 | Foot down. | Modeled | Servo holes are 2.5 mm: use the MG996R's own screws.
Doser rotor (60 mm notched) | rotor_60mm.step (earlier draft) | 3 | PETG | any | 99.8 | 1.27 | 0.55 | 209.1309 | 60 x 60 x 38 | Servo face down. 4 walls, 40%. | NOT in the assembly | Re-check against the MG996R shaft position (Z ~612) before printing.
Pit servo mount | your servo_mount part | 1 | PETG | any | 108.4 | 1.27 | 0.55 | 75.7174 | 74 x 49 x 36 |  | Modeled
Solenoid mount | your solenoid_mount part | 1 | PETG | any | 15.5 | 1.27 | 0.90 | 17.7165 | 54 x 44 x 22 |  | Modeled
Trapdoor frame (?) | your Trapdoor part | 1 | PETG | any | 150.8 | 1.27 | 0.55 | 105.3338 | 218 x 148 x 30 | Needs a 220+ mm bed. | Modeled | Print or cut? - your call.
Trapdoor top plate (?) | your top_door part | 1 | PETG | any | 172.9 | 1.27 | 0.50 | 109.7915 | 148 x 148 x 8 |  | Modeled | Could be 6 mm ply or acrylic instead.
Chute (?) | your Chute_new part | 1 | PETG | any | 44.7 | 1.27 | 0.95 | 53.93055 | 105 x 372 x 204 | Too long for most beds (~424 mm along the slope). | Modeled | Split in 2 halves, or bend it from 0.040in 5052 at SendCutSend.
Filament totals
PETG |  |  |  |  |  |  | grams: | 946.6961 | 1 kg spools: | 1
ASA |  |  |  |  |  |  | grams: | 323.0862325 | 1 kg spools: | 1
Grams = qty x solid volume x density x fill factor (fill factor ~0.5-0.6 for chunky parts at 3-4 walls / 25-40% infill, ~0.85-0.95 for thin-walled parts) x (1 + print-waste allowance on Summary). No PLA: it creeps in summer sun.

Sheet: Cut
Part | Material / stock | Thickness | Finished size (mm) | Qty | Process | Source file | Notes
A. SendCutSend (order these cut) - cost is on the Buy tab
Reward tray | 5052-H32 aluminum | 0.080" (2.03 mm) | 376 x 79 x 50 (bent) | 1 | laser + 3 bends | CrowBox_RewardTray_5052_0p080_v2.step | As modeled.
Reward bottom plate | 5052-H32 aluminum | 0.187" (4.75 mm) | 450 x 95 | 1 | laser | CrowBox_RewardBottomPlate_v3.step | SCS has no 4 mm 5052. Order 0.187in: top stays at Z 280, the extra 0.75 mm goes down, gap to the front bar drops to 0.25 mm, so skip the 1 mm shims.
Gate | Polycarbonate (clear) | 0.177" (4.5 mm) | 457.7 x 95 | 1 | CNC routed | export from your Gate body | Model is 4 mm; SCS polycarbonate comes in 3.0 / 4.5 / 5.6 mm. 4.5 mm still slides in the 6.2 mm slots.
OPTION: clear front panel | Polycarbonate (clear) | 0.220" (5.6 mm) | 502 x 1100 | 1 | CNC routed | FrontPanel_6mm in Panels_v3 | Only if you go clear. Fits SCS's 30 x 44 in limit. Keep the PIR slot open; paint/opaque film over the pit zone.
B. Wood (cut at home or have the store rip the sheets)
Side panel L / R | Sheet A: 1/4in exterior ply 4x8 | 6 mm | 425 x 1100 | 2 | circular saw + drill | CrowBox_Panels_v3.step | Sheet A row 1: side + back; row 2: side + front (1100 along the 8 ft side).
Back panel | Sheet A | 6 mm | 490 x 1100 | 1 | saw + jigsaw (gland window) | CrowBox_Panels_v3.step | v3: gland window 106 x 65 behind the JB; JB mount holes; no Z 360 holes.
Front panel | Sheet A | 6 mm | 502 x 1100 | 1 | saw + jigsaw (3 windows) | CrowBox_Panels_v3.step | Windows: reward 160 x 44, PIR slot 190 x 16, object 120 x 60.
Roof | Sheet B: 1/4in ply 2x4 project panel | 6 mm | 522 x 452 | 1 | saw + drill | CrowBox_Roof_Solar.step | Sheet B along the 4 ft side: roof 452 + bay floor 418 + shelf 148 = 1018 mm.
Bay floor v2 | Sheet B | 6 mm | 486 x 418 | 1 | saw + jigsaw (chute slot) | CrowBox_BayFloor_v2.step
Battery shelf v2 | Sheet B | 6 mm | 486 x 148 | 1 | saw + jigsaw (notches, strap slots) | CrowBox_FieldModules.step | v2 adds 4 x M5 holes into the bottom side bars + 2 x M4 for the controller.
Pit lining | 1/8in tempered hardboard 2x4 | 3 mm | 150 x 150 (2), 144 x 150 (2) | 4 | saw | CrowBox_PitLining_LightRing.step | Paint matte light grey. VHB to the pit bars.
Legs | 2x2 x 8 ft pressure-treated (38 x 38) | - | 38 x 38 x 960 | 4 | miter saw | CrowBox_Legs_v2.step | Boards 1-2: 960 + 960 + 502 each; board 3: 362 + 362.
Ground aprons L / R | 2x2 PT | - | 38 x 38 x 362 | 2 | miter saw | CrowBox_Legs_v2.step
Ground apron back + raised front apron | 2x2 PT | - | 38 x 38 x 502 | 2 | miter saw | CrowBox_Legs_v2.step
Diagonals L / R | 1x2 x 8 ft (19 x 38) | - | ~660 (angle-cut to fit) | 2 | miter saw | CrowBox_Legs_v2.step | One 8 ft 1x2 gives 660 + 660 + 750 + scrap.
Diagonal back | 1x2 | - | ~750 (angle-cut to fit) | 1 | miter saw | CrowBox_Legs_v2.step
Skirt corner cleats | 3/4in square dowel | - | 19 x 19 x 90 | 4 | saw | CrowBox_Panels_v3.step
Perch rods | 1-1/4" hardwood dowel (31.75 mm) | - | 525 | 2 | saw | CrowBox_Perch_D.step | Not a 1-5/16in closet pole: it won't fit the printed brackets.
C. 2020 extrusion cut list (from 1000 mm sticks, 3 mm kerf)
Length (mm) | Where |  |  | Qty | Total (mm)
1000 | posts |  |  | 4 | 4000
490 | full-width crossbars (bottom front/back, reward level x3) |  |  | 5 | 2450
450 | between-post bars (reward back, bay x2, roof front/back) |  |  | 5 | 2250
380 | side bars (bottom, reward, bay, roof) x2 sides |  |  | 8 | 3040
170 | pit corner verticals |  |  | 4 | 680
150 | pit top/bottom rings + 1 under the solenoid side |  |  | 9 | 1350
Total |  |  |  | 35 | 13770
1000 mm sticks needed |  |  |  | 15 | Plan: 4 x [1000]; 2 x [490+490]; [490+450]; 2 x [450+450]; 2 x [380+380+170]; 2 x [380+380+150]; [170+170+150x4]; [150x3]
Counts are after removing the duplicate pit bars in the model (see Model fixes): 4 x 150 removed. Square, deburred ends matter more than exact length; a miter saw with a non-ferrous blade, or order cut-to-length.

Sheet: Buy
ID | Section | Item | Spec / part no. | Need | Unit | Pack size | Packs | $ / pack (est.) | Line $ | Have? (Y = received, O = ordered) | Still to buy $ | Phase | Used for | Notes / price basis
F01 | Frame | 2020 T-slot extrusion, 1000 mm | 20x20, 6 mm slot (M5), 10-pack | 15 | sticks | 10 | 2 | $66.90 | $133.80 | O | $133.80 | Build | 35 bars, cut list on Cut tab | VEVOR 10 x 1000 mm, vevor.com $65.90-66.90 (Oct 2026). Or order cut-to-length.
F02 | Frame | 2020 corner bracket kit | cast 20x28x28 ('2028') with M5 screws + T-nuts, 40 sets | 78 | brackets | 40 | 2 | $22.00 | $44.00 | Y | $44.00 | Build | 70 positions in the model + 8 under the roof top bars | Model uses McMaster 5537T935 (~$5-6 each, ~$430 for 78). Generic is 2 mm bigger: check the bay-floor corner notches. est. US retail Oct 2026
F03 | Frame | M5 drop-in T-nut | for 2020 / 6 mm slot | 150 | pcs | 100 | 2 | $9.00 | $18.00 | Y | $18.00 | Build | everything screwed into a slot (not brackets) | est. US retail Oct 2026
X01 | Fasteners | M5 x 8 button head | ISO 7380, A2 stainless | 8 | pcs | 50 | 1 | $7.00 | $7.00 | O | $7.00 | Build | light ring, vision box ears | est. US retail Oct 2026
X02 | Fasteners | M5 x 10 button head | ISO 7380, A2 | 17 | pcs | 50 | 1 | $7.00 | $7.00 | O | $7.00 | Build | bottom plate, chute bracket | est. US retail Oct 2026
X03 | Fasteners | M5 x 12 button head | ISO 7380, A2 | 82 | pcs | 100 | 1 | $11.00 | $11.00 | O | $11.00 | Build | panels, roof, bay floor, shelf, PIR housing | est. US retail Oct 2026
X04 | Fasteners | M5 x 16 button head | ISO 7380, A2 | 23 | pcs | 50 | 1 | $8.00 | $8.00 | O | $8.00 | Build | front panel, solar feet, pod, JB top | est. US retail Oct 2026
X05 | Fasteners | M5 x 20 button head | ISO 7380, A2 | 2 | pcs | 25 | 1 | $6.00 | $6.00 | O | $6.00 | Build | JB bottom bolts | est. US retail Oct 2026
X06 | Fasteners | M5 x 25 flanged button head | ISO 7380-2, A2 | 4 | pcs | 20 | 1 | $8.00 | $8.00 | O | $8.00 | Build | perch brackets | est. US retail Oct 2026
X07 | Fasteners | M5 x 50 button or socket head | A2 | 12 | pcs | 25 | 1 | $10.00 | $10.00 | O | $10.00 | Build | legs to posts | est. US retail Oct 2026
X08 | Fasteners | M5 x 75 hex bolt | A2, part-thread OK | 4 | pcs | 10 | 1 | $8.00 | $8.00 |  | $8.00 | Build | skirt bolts | est. US retail Oct 2026
X09 | Fasteners | M5 flat washer | ISO 7089, 10 mm OD, A2 | 104 | pcs | 200 | 1 | $8.00 | $8.00 | O | $8.00 | Build | under heads on plywood | est. US retail Oct 2026
X10 | Fasteners | M5 fender washer | 5.3 x 20 mm, A2 | 20 | pcs | 25 | 1 | $6.00 | $6.00 | O | $6.00 | Build | legs, skirt bolts | est. US retail Oct 2026
X11 | Fasteners | M5 nylon-insert lock nut | A2 | 6 | pcs | 50 | 1 | $5.00 | $5.00 | O | $5.00 | Build | JB bottom, skirt bolts | est. US retail Oct 2026
X12 | Fasteners | M5 hex nut | A2, 8 mm AF | 4 | pcs | 50 | 1 | $4.00 | $4.00 | O | $4.00 | Build | chute to bracket | est. US retail Oct 2026
X13 | Fasteners | M5 unthreaded spacer, 5 mm long | ~10 mm OD, nylon or aluminum | 0 | pcs | 25 | 1 | $8.00 | $8.00 |  | $8.00 | Build | front panel standoffs | DROPPED: front panel standoffs are stacks of 5 M5 washers instead.
X14 | Fasteners | M4 x 16 button head | ISO 7380, A2 | 4 | pcs | 25 | 1 | $5.00 | $5.00 | O | $5.00 | Build | load cell fixed end, controller | est. US retail Oct 2026
X15 | Fasteners | M4 x 20 button head | ISO 7380, A2 | 8 | pcs | 25 | 1 | $5.00 | $5.00 | O | $5.00 | Build | tray to load cell, cradles | est. US retail Oct 2026
X16 | Fasteners | M4 nylon-insert lock nut | A2 | 8 | pcs | 50 | 1 | $4.00 | $4.00 | O | $4.00 | Build | cradles, controller | est. US retail Oct 2026
X17 | Fasteners | M4 flat washer | A2 | 20 | pcs | 100 | 1 | $4.00 | $4.00 | O | $4.00 | Build | load cell, cradles, controller | est. US retail Oct 2026
X18 | Fasteners | Spacer M4 x 11 mm | McMaster 92871A311 (18-8) | 0 | pcs | 1 | 2 | $2.50 | $5.00 |  | $5.00 | Build | tray to load cell | DROPPED: load cell spacer is 3 M4 hex nuts + 3 M4 washers instead.
X19 | Fasteners | Spacer M4 x 5 mm | McMaster 92871A008 (18-8) | 0 | pcs | 1 | 2 | $2.00 | $4.00 |  | $4.00 | Build | load cell fixed end | DROPPED: load cell spacer is 6 M4 washers instead.
X20 | Fasteners | #8 x 2-1/2in exterior screw | coated deck screw | 16 | pcs | 50 | 1 | $8.00 | $8.00 |  | $8.00 | Build | aprons | est. US retail Oct 2026
X21 | Fasteners | #8 x 1-1/4in exterior screw | coated | 12 | pcs | 50 | 1 | $6.00 | $6.00 |  | $6.00 | Build | diagonals | est. US retail Oct 2026
X22 | Fasteners | #6 x 5/8in wood screw | pan or flat head | 16 | pcs | 50 | 1 | $5.00 | $5.00 |  | $5.00 | Build | skirt cleats | est. US retail Oct 2026
X23 | Fasteners | #6 x 3/4in pan-head screw |  | 4 | pcs | 25 | 1 | $4.00 | $4.00 |  | $4.00 | Build | perch rod locks | est. US retail Oct 2026
X24 | Fasteners | Nylon standoff kit M2 / M2.5 / M3 | standoffs + screws + nuts | 1 | kit | 1 | 1 | $12.00 | $12.00 | Y | $12.00 | Build | P4 board, camera, JB modules | est. US retail Oct 2026
X25 | Fasteners | Pit mechanism hardware (?) | servo mount, solenoid mount, trapdoor hinge | 1 | lot | 1 | 1 | $8.00 | $8.00 |  | $8.00 | Build | your pit design (not specified) | placeholder
X26 | Fasteners | Gate actuator clevis pins / rod-end jaws (?) | M4, per your gate design | 2 | pcs | 2 | 1 | $10.00 | $10.00 |  | $10.00 | Build | replace the clevis stand-ins | placeholder
S01 | Wood & sheet | 1/4in (6 mm) exterior-glue plywood, 4 x 8 ft | BC sanded or similar | 1 | sheet | 1 | 1 | $42.00 | $42.00 |  | $42.00 | Build | Sheet A: side x2, back, front | est. US retail Oct 2026 (home center)
S02 | Wood & sheet | 1/4in (6 mm) plywood, 2 x 4 ft project panel |  | 1 | sheet | 1 | 1 | $17.00 | $17.00 |  | $17.00 | Build | Sheet B: roof, bay floor, battery shelf | est. US retail Oct 2026
S03 | Wood & sheet | 1/8in (3 mm) tempered hardboard, 2 x 4 ft |  | 1 | sheet | 1 | 1 | $9.00 | $9.00 |  | $9.00 | Build | pit lining | est. US retail Oct 2026
S04 | Wood & sheet | 2x2 x 8 ft, pressure-treated | actual 1.5 x 1.5 in (38 mm) | 3 | boards | 1 | 3 | $6.00 | $18.00 |  | $18.00 | Build | legs + aprons (ground contact) | est. US retail Oct 2026
S05 | Wood & sheet | 1x2 x 8 ft | actual 0.75 x 1.5 in | 1 | boards | 1 | 1 | $3.00 | $3.00 |  | $3.00 | Build | diagonals | est. US retail Oct 2026
S06 | Wood & sheet | 3/4in square dowel, 36in |  | 1 | pcs | 1 | 1 | $3.00 | $3.00 |  | $3.00 | Build | skirt corner cleats | est. US retail Oct 2026
S07 | Wood & sheet | 1-1/4in hardwood dowel, 48in | 31.75 mm - not 1-5/16in closet pole | 1 | pcs | 1 | 1 | $12.00 | $12.00 |  | $12.00 | Build | perch rods x2 | est. US retail Oct 2026
S08 | Wood & sheet | Exterior primer + paint, 1 qt | or exterior sealer | 1 | qt | 1 | 1 | $20.00 | $20.00 |  | $20.00 | Build | all wood | est. US retail Oct 2026
C01 | Cut service | Reward tray (SendCutSend) | 5052-H32 0.080", 3 bends | 1 | part | 1 | 1 | $40.00 | $40.00 |  | $40.00 | Build | reward tray | est.; get the real quote by uploading the STEP
C02 | Cut service | Reward bottom plate (SendCutSend) | 5052-H32 0.187" | 1 | part | 1 | 1 | $32.00 | $32.00 |  | $32.00 | Build | bottom plate v3 | est.
C03 | Cut service | Gate (SendCutSend) | polycarbonate 0.177" (4.5 mm), routed | 1 | part | 1 | 1 | $22.00 | $22.00 |  | $22.00 | Build | gate | est.
C04 | Cut service | OPTION: clear front panel | polycarbonate 0.220" (5.6 mm), 502 x 1100 | 1 | part | 1 | 1 | $160.00 | $160.00 |  | $160.00 | Option | front panel | est.; only if you go clear
E01 | Junction box | IP65 junction box ~250 x 200 x 100 with mounting plate | ABS or PC, hinged or screw lid | 1 | pcs | 1 | 1 | $28.00 | $28.00 | O | $28.00 | Build | main electronics | Modeled Ruilogod 200x120x75 is too small for the doc's module list (see Doc check). If you already have it, mark Y and expect a cramped 2-layer build. est. US retail Oct 2026
E02 | Junction box | ESP32 dev board, 38-pin (HiLetgo, ESP-WROOM-32) |  | 1 | pcs | 1 | 1 | $8.00 | $8.00 | Y | $8.00 | Build | main controller | est. US retail Oct 2026
E03 | Junction box | ESP32 38-pin screw-terminal breakout | must fit a 38-pin board: match pin-row spacing (usually 25.4 mm); size per listing | 1 | pcs | 1 | 1 | $8.00 | $8.00 | Y | $8.00 | Build |  | est. US retail Oct 2026
E04 | Junction box | MCP23017 I/O expander breakout |  | 1 | pcs | 1 | 1 | $5.00 | $5.00 | Y | $5.00 | Build | IR, LEDs, gate dir, solenoid lines | est. US retail Oct 2026
E05 | Junction box | L298N dual H-bridge | 43 x 43 x 27 | 1 | pcs | 1 | 1 | $5.00 | $5.00 | Y | $5.00 | Build | gate actuators | est. US retail Oct 2026
E06 | Junction box | Logic-level MOSFET switch module | AOD4184 / D4184 type, works from 3.3 V | 2 | pcs | 5 | 1 | $9.00 | $9.00 | Y | $9.00 | Build | solenoid, light ring | Replaces the doc's IRF520 modules: an IRF520 barely turns on from 3.3 V logic. est. US retail Oct 2026
E07 | Junction box | Buck 12->5 V, LM2596 with voltmeter | set 5.1 V | 1 | pcs | 1 | 1 | $6.00 | $6.00 | Y | $6.00 | Build | logic rail (ESP32, MCP, pod, IR) | est. US retail Oct 2026
E08 | Junction box | Buck 12->6 V, 5 A or more, with display | XL4015 / XL4016 type | 1 | pcs | 1 | 1 | $10.00 | $10.00 | Y | $10.00 | Build | servo rail (4 x MG996R) | Doc left buck #2's job open: make it the servo rail. MG996R stalls at ~2.5 A each; an LM2596 sags. est. US retail Oct 2026
E10 | Junction box | WAGO 221-415 lever connector (5-port) |  | 10 | pcs | 10 | 1 | $15.00 | $15.00 | Y | $15.00 | Build | 12 V, 6 V, 5 V, GND buses | Doc said ~5; GND alone has ~18 wires. est. US retail Oct 2026
E11 | Junction box | ATC inline fuse holder, 16 AWG, waterproof |  | 2 | pcs | 2 | 1 | $7.00 | $7.00 | Y | $7.00 | Build | fuse 1 at battery (7.5 A), fuse 2 in JB (5 A) | Two fuses: fuse 1 protects the battery cable, fuse 2 is the reachable one the doc asked for. est. US retail Oct 2026
E12 | Junction box | ATC blade fuse assortment | incl. 5 A and 7.5 A | 1 | kit | 1 | 1 | $6.00 | $6.00 | Y | $6.00 | Build |  | est. US retail Oct 2026
E13 | Junction box | 1N4007 diode | flyback | 1 | pack | 1 | 1 | $4.00 | $4.00 | Y | $4.00 | Build | across the solenoid | est. US retail Oct 2026
E14 | Junction box | Electrolytic capacitors | 1000 uF 16 V (servo rail), 470 uF 25 V (12 V bus) | 1 | kit | 1 | 1 | $7.00 | $7.00 | Y | $7.00 | Build | rail buffering | est. US retail Oct 2026
E15 | Junction box | Resistor assortment (?) | need 3 x 330 ohm for the LEDs | 1 | kit | 1 | 1 | $8.00 | $8.00 | Y | $8.00 | Build | signal LEDs | est. US retail Oct 2026
E16 | Junction box | Main power switch, sealed | 12 V 10 A toggle/rocker with boot | 1 | pcs | 1 | 1 | $7.00 | $7.00 |  | $7.00 | Build | on/off in the JB side wall | Recommended: fuse 1 sits behind a panel, so pulling it isn't a practical off switch. est. US retail Oct 2026
E17 | Junction box | SAE 2-pin pigtail (?) | charge port on the 12 V input | 2 | pcs | 2 | 1 | $7.00 | $7.00 |  | $7.00 | Build | charging before solar | est. US retail Oct 2026
E18 | Junction box | Notecarrier-A | Blues | 1 | pcs | 1 | 1 | $25.00 | $25.00 | O | $25.00 | Phase 5 | cellular | shop.blues.com $25.00
E19 | Junction box | Notecard Cellular | Blues MBNAN: LTE Cat-1 bis, North America (the LTE-M NBNAN is quote-only, MOQ 250) | 1 | pcs | 1 | 1 | $49.00 | $49.00 | O | $49.00 | Phase 5 | cellular | shop.blues.com $49.00 (MBNAN), Oct 2026. Includes 10 years / 500 MB.
V01 | Vision box | Clear-lid IP65 box 115 x 90 x 55 with ears | Anbox 115A-type | 1 | pcs | 1 | 1 | $12.00 | $12.00 | Y | $12.00 | Build | vision enclosure | est. US retail Oct 2026
V02 | Vision box | Waveshare ESP32-P4-NANO (basic kit) | ESP32-P4, 32 MB PSRAM, standard 15-pin Pi camera connector, microSD, 50 x 50 mm | 1 | pcs | 1 | 1 | $19.00 | $20.00 | O | $20.00 | Build | vision (camera + classifier) | Waveshare list $18.99, Oct 2026. Replaces the Pi Zero 2 WH. Not KIT-A: its camera's 6 mm lens is too narrow at 300 mm.
V03 | Vision box | OV5647 camera, Raspberry Pi v1.3-style (25 x 24 mm) | 3.6 mm lens, WITH IR filter (not NoIR / night vision); includes 15-pin cable | 1 | pcs | 1 | 1 | $12.00 | $25.00 | Y | $25.00 | Build | vision | est. $10-15 US retail Oct 2026 (approximate). Replaces Camera Module 3, which only works with Raspberry Pi boards.
V04 | Vision box | DROPPED: Pi Zero camera cable 22->15 pin |  | 0 | pcs | 1 | 1 | $6.00 | $6.00 |  | $6.00 | Build | not needed | Not needed: the P4-NANO has the standard 15-pin connector, so the camera's own cable fits.
V05 | Vision box | microSD 32 GB, high-endurance |  | 1 | pcs | 1 | 1 | $10.00 | $10.00 | O | $10.00 | Build | training photos (P4 board's microSD slot) | est. US retail Oct 2026
V06 | Vision box | Mini buck 12->5 V 3 A (MP1584EN), 6-pack |  | 1 | pack | 1 | 1 | $9.00 | $9.00 | Y | $9.00 | Build | P4 board + PIR power from the Cat6 12 V | est. US retail Oct 2026
V07 | Vision box | DROPPED: Coral USB Accelerator |  | 0 | pcs | 1 | 1 | $60.00 | $60.00 |  | $60.00 | Phase 7 | inference | Not needed: the classifier runs on the ESP32-P4 itself (ESP-DL, int8).
V08 | Vision box | DROPPED: Right-angle USB-C to micro-USB OTG cable | short | 0 | pcs | 1 | 1 | $8.00 | $8.00 |  | $8.00 | Phase 7 | not needed | Not needed: the Coral is dropped.
M01 | Field modules | MG996R servo | metal gear | 4 | pcs | 4 | 1 | $24.00 | $24.00 | Y | $24.00 | Build | 3 dosers + trapdoor | est. US retail Oct 2026
M02 | Field modules | 12 V solenoid deadbolt (Bonsicoky) |  | 1 | pcs | 1 | 1 | $14.00 | $14.00 | Y | $14.00 | Build | trapdoor lock | est. US retail Oct 2026
M03 | Field modules | Mini 12 V linear actuator, 50 mm stroke | as modeled | 2 | pcs | 1 | 2 | $35.00 | $70.00 | Y | $70.00 | Build | gate | Price for generic minis. 50 mm stroke limits the reward window to 44 mm tall; 100 mm stroke would fix that. est. US retail Oct 2026
M04 | Field modules | 1 kg straight-bar load cell + HX711 kit | 80 x 12.7 x 12.7 | 2 | kits | 1 | 2 | $9.00 | $18.00 | Y | $18.00 | Build | reward tray + pit; HX711 #1 in vision box, #2 in JB | est. US retail Oct 2026
M05 | Field modules | AM312 mini PIR, 5-pack |  | 1 | pack | 1 | 1 | $8.00 | $8.00 | Y | $8.00 | Build | PIR housing | est. US retail Oct 2026
M06 | Field modules | Passive buzzer module (3-pin, with transistor), 5-pack |  | 1 | pack | 1 | 1 | $6.00 | $6.00 | Y | $6.00 | Build | signal pod | est. US retail Oct 2026
M07 | Field modules | 5 mm diffused LEDs, green / red / blue | assortment | 1 | kit | 1 | 1 | $6.00 | $6.00 | Y | $6.00 | Build | signal pod | est. US retail Oct 2026
M08 | Field modules | 12 V COB LED strip, 8 mm, 4000-5000 K, CRI 90+ | need ~0.5 m | 1 | roll | 1 | 1 | $14.00 | $14.00 |  | $14.00 | Build | pit light ring | Doc said a 5 V strip under the reward floor; the model uses 12 V on the pit ring (switched from 12 V, no load on the 5 V buck). est. US retail Oct 2026
M09 | Field modules | IR break-beam pair, 5 mm | e.g. Adafruit 2168 | 3 | pairs | 1 | 3 | $6.00 | $18.00 |  | $18.00 | Paused | hopper empty detection | est. US retail Oct 2026
P01 | Power | 12 V LiFePO4 battery, 8 Ah | ~151 x 65 x 95, F2 terminals | 1 | pcs | 1 | 1 | $40.00 | $40.00 | Y | $40.00 | Build | battery shelf | est. US retail Oct 2026
P02 | Power | Hook-and-loop strap 25 mm x 50 cm |  | 1 | pack | 1 | 1 | $6.00 | $6.00 |  | $6.00 | Build | battery hold-down (shelf slots) | est. US retail Oct 2026
P03 | Power | LiFePO4 charger 14.6 V, 2-5 A (?) |  | 1 | pcs | 1 | 1 | $22.00 | $22.00 |  | $22.00 | Build | charging until solar | 8 Ah lasts ~1.5-2 days at ~2-3 W average. est. US retail Oct 2026
P04 | Power | Solar panel 20 W, 12 V | ~470 x 345 x 20 | 1 | pcs | 1 | 1 | $42.00 | $42.00 |  | $42.00 | Phase 9 | roof | est. US retail Oct 2026
P05 | Power | Small-panel tilt mount kit |  | 1 | kit | 1 | 1 | $18.00 | $18.00 |  | $18.00 | Phase 9 | roof | est. US retail Oct 2026
P06 | Power | Victron SmartSolar MPPT 75/10 | 113 x 100 x 40, LiFePO4 profile, load output | 1 | pcs | 1 | 1 | $69.97 | $69.97 |  | $69.97 | Phase 9 | battery shelf | solarcellzusa.com $69.97. Budget alt: Renogy Wanderer 10A $34.99, but its page doesn't list lithium support.
CB10 | Wiring | 3-core 22 AWG round jacketed cable | PVC, OD ~4.2 mm | 5.6 | m | 7.6 | 1 | $13.00 | $13.00 |  | $13.00 | Build | 4 servos + PIR | 25 ft roll. est. US retail Oct 2026
CB11 | Wiring | 2-core 20 AWG round jacketed cable | OD ~4.3 mm | 5.9 | m | 7.6 | 1 | $12.00 | $12.00 |  | $12.00 | Build | actuators, solenoid, light ring | 25 ft roll. est. US retail Oct 2026
CB12 | Wiring | 6-core 24 AWG round cable | OD ~4.8 mm | 1.2 | m | 7.6 | 1 | $15.00 | $15.00 |  | $15.00 | Build | signal pod (IR later from the same roll) | 25 ft roll. est. US retail Oct 2026
CB13 | Wiring | 4-core 24 AWG shielded cable | foil + drain, OD ~4.6 mm | 1.9 | m | 3 | 1 | $11.00 | $11.00 |  | $11.00 | Build | pit load cell | 10 ft roll. est. US retail Oct 2026
CB14 | Wiring | Cat6 patch cable, stranded, 5 ft | plugs cut off | 0.9 | m | 1.5 | 1 | $6.00 | $6.00 |  | $6.00 | Build | vision box link | est. US retail Oct 2026
CB15 | Wiring | 2-core 16 AWG round jacketed cable | OD <= 7.5 mm for the PG9 | 1.3 | m | 3 | 1 | $10.00 | $10.00 |  | $10.00 | Build | 12 V power in | 10 ft. est. US retail Oct 2026
CB16 | Wiring | 2-core 18 AWG UV-rated outdoor cable | OD ~6 mm | 1.3 | m | 3 | 1 | $9.00 | $9.00 |  | $9.00 | Phase 9 | solar run | 10 ft. est. US retail Oct 2026
CB17 | Wiring | 16 AWG red/black zip wire |  | 0.8 | m | 3 | 1 | $7.00 | $7.00 |  | $7.00 | Build | battery leads | 10 ft. est. US retail Oct 2026
CB18 | Wiring | 22 AWG stranded hookup wire, 6 colors |  | 1 | kit | 1 | 1 | $14.00 | $14.00 |  | $14.00 | Build | inside the JB | est. US retail Oct 2026
CB19 | Wiring | PG16 nylon gland with 4-hole insert | 4 x 5 mm holes | 3 | pcs | 5 | 1 | $13.00 | $13.00 |  | $13.00 | Build | JB G1-G3 | est. US retail Oct 2026
CB20 | Wiring | Cable gland assortment PG7 / PG9 / PG11 | nylon, IP68 | 1 | kit | 1 | 1 | $12.00 | $12.00 |  | $12.00 | Build | JB G4/G5, vision box x3, roof | est. US retail Oct 2026
CB21 | Wiring | Ferrule assortment 22-16 AWG |  | 1 | kit | 1 | 1 | $8.00 | $8.00 |  | $8.00 | Build | screw terminals | est. US retail Oct 2026
CB22 | Wiring | F2 (6.3 mm) insulated female spade terminals |  | 1 | pack | 1 | 1 | $6.00 | $6.00 |  | $6.00 | Build | battery terminals | est. US retail Oct 2026
CB23 | Wiring | 2.54 mm male header strips | 40-pin, 10-pack | 1 | pack | 1 | 1 | $5.00 | $5.00 |  | $5.00 | Build | servo + LED connections | est. US retail Oct 2026
CB24 | Wiring | Pre-crimped Dupont F-F jumpers |  | 1 | pack | 1 | 1 | $6.00 | $6.00 |  | $6.00 | Build | PIR, HX711 headers | est. US retail Oct 2026
CB25 | Wiring | Heat-shrink assortment 2:1 |  | 1 | kit | 1 | 1 | $8.00 | $8.00 |  | $8.00 | Build |  | est. US retail Oct 2026
CB26 | Wiring | Adhesive-lined heat-shrink 3:1 |  | 1 | kit | 1 | 1 | $9.00 | $9.00 |  | $9.00 | Build | splices outside boxes | est. US retail Oct 2026
CB27 | Wiring | UV-resistant black zip ties, 4in + 8in | 200 pcs | 1 | pack | 1 | 1 | $8.00 | $8.00 |  | $8.00 | Build |  | est. US retail Oct 2026
CB28 | Wiring | Adhesive zip-tie mounts | 50 pcs | 1 | pack | 1 | 1 | $6.00 | $6.00 |  | $6.00 | Build | back panel, bay floor | est. US retail Oct 2026
CB29 | Wiring | 2020 slot cable clips | 50 pcs | 1 | pack | 1 | 1 | $9.00 | $9.00 |  | $9.00 | Build | runs along bars/posts | est. US retail Oct 2026
CB30 | Wiring | Split loom 1/4in x 10 ft |  | 1 | pack | 1 | 1 | $7.00 | $7.00 |  | $7.00 | Build | bundles, bay-floor holes | est. US retail Oct 2026
CB31 | Wiring | Neutral-cure silicone |  | 1 | tube | 1 | 1 | $7.00 | $7.00 |  | $7.00 | Build | JB back face, glands | est. US retail Oct 2026
CB32 | Wiring | 3M VHB tape 1in (5952) |  | 1 | roll | 1 | 1 | $13.00 | $13.00 |  | $13.00 | Build | pit lining, signal pod | est. US retail Oct 2026
FL1 | Filament | PETG 1.75 mm, 1 kg |  | 1 | spools | 1 | 1 | $20.00 | $20.00 |  | $20.00 | Build | parts on Print tab | est. US retail Oct 2026
FL2 | Filament | ASA 1.75 mm, 1 kg | UV-stable | 1 | spools | 1 | 1 | $24.00 | $24.00 |  | $24.00 | Build | perch brackets, signal pod | est. US retail Oct 2026
I01 | Install | Ground anchors / stakes (?) | or sandbags on the ground aprons | 4 | pcs | 4 | 1 | $18.00 | $18.00 |  | $18.00 | Build | box is ~1.9 m tall | est. US retail Oct 2026
 |  | Totals (all phases incl. options) |  |  |  |  |  |  | $1765.77 |  | $1765.77

Sheet: Tooling
Tool | Needed for | Est. $ | Have? (Y) | Still to buy $ | Notes
3D printer, 220+ mm bed (?) | printed parts; trapdoor frame is 218 mm | $0 |  | $0 | assumed owned
Hex keys 2.5 / 3 / 4 mm | M4 + M5 button heads, socket heads | $8 | Y | $8
Cordless drill/driver (?) | everything | $0 |  | $0 | assumed owned
Drill bits: 4.5, 5.5, 8 mm + 1/8in pilot (?) | M4/M5 clearance, cable holes, wood screws | $12 | Y | $12
Step drill to 25 mm (?) | gland holes 12.5 / 15.5 / 22.5-23 mm in the JB and vision box | $18 | Y | $18
Jigsaw (?) | front-panel windows, back-panel gland window, bay-floor chute slot | $0 |  | $0 | or a hole saw + file
Circular saw or store rip cuts (?) | plywood panels | $0 |  | $0 | home centers rip sheets free
Miter saw + non-ferrous blade (?) | 2020 extrusion (31 cuts), 2x2, 1x2 | $30 |  | $30 | blade price; or order the extrusion cut-to-length
Deburring tool / file (?) | extrusion ends, plate holes | $8 |  | $8
Soldering iron + solder + flux (?) | servo headers, splices, LED leads | $0 |  | $0 | assumed owned
Heat gun (?) | heat-shrink, adhesive-lined splices | $20 |  | $20
Wire strippers 16-26 AWG (?) | all cables | $12 | Y | $12
Ferrule crimper (?) | screw-terminal ends | $18 |  | $18 | often sold with the ferrule kit
Dupont crimper (?) | only if you crimp your own Dupont ends | $22 |  | $22 | skip with pre-crimped jumpers
Multimeter (?) | bucks, polarity, continuity | $0 | Y | $0 | assumed owned
Calipers (?) | measure modules before finalizing (the doc asks for this) | $15 | Y | $15
Clamps, square, tape measure | panels, legs | $0 |  | $0 | assumed owned
Paint brush / small roller | plywood | $8 |  | $8
Micro-USB data cable | flashing the ESP32 | $5 |  | $5
microSD reader (?) | reading training photos off the P4's microSD | $8 |  | $8
Total |  | $184 |  | $184
"?" = not sure you have it or need it. Items at $0 are assumed owned. No tap set needed: nothing in the design is tapped.

Sheet: Unmodeled
Item | In the model now? | Needs a model? | What to do
Doser servos x3 (MG996R) | ADDED: CrowBox_FieldModules | done | Placed on the cradles' existing 49.5 x 10 hole pattern, shaft toward the bottle, body hanging outboard.
Signal pod (3 LEDs + buzzer) | ADDED: FieldModules + _SignalPod_print | done | Sits on the bottom plate right of the PIR housing; nose through the PIR slot so the crow sees the LEDs ~45 mm under the reward window. Install before the tray (screw is under it).
Solar charge controller + 8 Ah battery + fuse 1 | ADDED: FieldModules | done | Controller lies flat on the shelf right of the battery; fuse holder on the battery lid.
All cable runs + vision-box glands | ADDED: CrowBox_Wiring_v2 | done | 19 runs, each at its real OD, ending at its gland hole. Replaces CrowBox_CableRoutes_BatteryShelf.
JB gland row | UPDATED: CrowBox_JunctionBox_v2 | done | 3 x PG16 multi-hole + 2 x PG9 in one low row; back panel gets one gland window (Panels_v3).
Doser rotors x3 | no (rotor_60mm.step exists from earlier) | YES | Add on the servo horns and check the pocket sits under the bottle mouth; the earlier rotor predates the MG996R switch.
Gatorade bottles x3 | no (placeholder STEP exists) | YES | Drop into the cradle rings to check bay height and roof clearance.
Corner brackets under the roof top bars x8 | no | YES | Simple; counted in the bracket kit.
Real gate clevises + actuator rear mounts | stand-ins only | YES | Once you pick the rod-end/clevis parts.
Trapdoor hinge / pivot | no | YES | Needed to check the load-cell cable's service loop and the trapdoor swing.
IR beam holders x3 | no (paused) | later | Cable W04 and gland hole G1-UL are reserved.
JB internals (ESP32, MCP23017, L298N, bucks, MOSFETs, WAGOs, HX711 #2, Notecard) | no | no | Your call: not modeled. But see Doc check: the modeled box is too small for them.
Vision-box internals added (HX711 #1, mini buck) | no | no | Small; standoffs on the floor beside the P4 board.
Cloth funnel at the object window | no | no | Craft part.
Fasteners, cable ties, clips | no | no | Counted on Fasteners / Buy.
Main power switch | no | no | Hole in the JB side wall.
Ground anchors | no | no

Sheet: Doc check
Doc item | Qty | In model? | Where / decision | Change vs the doc
ESP32 DevKit V1 + screw-terminal breakout | 1 | inside JB | JB (not modeled by choice)
MCP23017 | 1 | inside JB | JB
L298N | 1 | inside JB | JB | Fine at 3.3 V logic; actuators see ~2 V less than 12 V.
MOSFET driver modules | 2 | inside JB | JB | Use logic-level (AOD4184/D4184) instead of IRF520.
Buck converters with voltmeter | 2 | inside JB | #1 logic 5.1 V; #2 servo rail 6 V | #2 must be >= 5 A.
Notecarrier-A + Notecard | 1 | inside JB | Phase 5; mount on a plastic wall away from the L298N
Main junction box ~300 x 250 x 150 | 1 | Ruilogod 200x120x75 | Back of the box, outside the back panel | Too small. Board footprints ~21,000 mm2 (with spacing) vs 22,400 mm2 floor, before gland space and wiring. Get ~250 x 200 x 100.
Glands on the bottom face | - | back face, low row | Glands pass the back panel into the frame | Back face is inside the panels: no rain reaches it, and cables never run outside.
12 V LiFePO4 8 Ah | 1 | yes (shelf) | Battery shelf at the bottom back | Own spot (doc's open question). Placeholder updated from 6 Ah to 8 Ah.
Inline fuse 5 A | 1 | yes | Fuse 1 (7.5 A) on the battery lid + fuse 2 (5 A) in the JB | Two fuses: one protects the cable, one is reachable.
WAGO 221 | ~5 | inside JB |  | ~10 x 221-415 needed.
Main power switch | ? | no | JB side wall | Recommended.
Clear-lid IP65 vision box | 1 | yes | Hangs from the two reward crossbars | Ears drilled to 5.5 mm for M5 T-nuts.
ESP32-P4-NANO / OV5647 camera (was Pi Zero 2 WH / Camera 3 / Coral) | 1 each | no - the fit-check blocks are still the Pi + Coral | Vision box | Replace the Pi + Coral blocks with the P4-NANO (50 x 50) and the OV5647 camera (25 x 24). No Coral; the camera uses its own 15-pin cable.
Vision box cable 4 wires (5 V, GND, TX, RX) | 1 | W08 Cat6 | Cat6, 8 conductors | Carries 12 V + PIR + reward HX711 too; mini buck inside makes 5 V.
Vision box: only one PG7 | - | 3 glands | 2 x PG7 front, 1 x PG9 back | PIR and reward load cell now land in the vision box.
MG996R dosers | 3 | ADDED | On the cradles
MG996R trapdoor | 1 | yes | Pit servo mount
Solenoid deadbolt | 1 | yes | Pit | Add flyback diode.
Linear actuators 50 mm | 2 | yes | Front posts | 50 mm stroke = 44 mm reward window.
Load cells 1 kg | 2 | yes | Reward tray + pit trapdoor | Pit cell rides the trapdoor: 10 cm service loop.
HX711 at each load cell | 2 | no (inside boxes) | #1 in the vision box (99 mm leads); #2 in the JB | Pit run is 1.2 m of shielded 4-core instead of a separate wet-zone box.
PIR facing down into the deposit chamber | 1 | yes | Your PIR housing faces forward out the PIR slot | Model kept as you built it.
IR beam pairs | 3 | paused | Reserved: W04 + gland hole | One shared 6-core instead of 3 cables.
Passive buzzer | 1 | ADDED | Inside the signal pod
Signal LEDs 5 mm | 3 | ADDED | Signal pod, visible through the PIR slot | No front-panel change needed.
5 V COB strip under the reward floor | 1 | 12 V strip on pit light ring | Pit light ring | 12 V version, switched by MOSFET.
Servo cables need PG9+ for the plug | - | no plugs through glands | Round 3-core through multi-hole PG16 | Servo plugs mate with soldered headers outside the JB.
Solar input (Phase 9) | 0-1 | yes | Roof panel + controller on the shelf | Solar no longer enters the JB.
Reward tray load cell (open question) | - | kept |  | You confirmed: keep it.

Sheet: Model fixes
# | Fix in Fusion | Detail
1 | Swap in the new files | Delete CrowBox_CableRoutes_BatteryShelf, CrowBox_JunctionBox, CrowBox_Panels_v2. Insert CrowBox_Wiring_v2, CrowBox_FieldModules, CrowBox_JunctionBox_v2, CrowBox_Panels_v3 (all in assembly coordinates).
2 | Delete 17 duplicate corner brackets | 87 bracket instances sit at 70 positions (2-5 copies at some spots, e.g. 5 at the back-right post Z 280).
3 | Delete duplicate pit bars | 5537T9 ':13' and ':14' copy the pit's top front/back bars; the two 150 mm verticals inside Object_Pit_v2 sit inside the 170 mm corner verticals.
4 | Delete the catch-bin placeholder | The unnamed block listed as [0:1:1:171] (X -300..75, Z -409..-153).
5 | Trim the chute's top tab | Pokes 4.4 mm into the back panel (Y 289.3 vs 284.9).
6 | Lower the PIR housing + AM312 0.8 mm | Still floats 0.8 mm above the plate.
7 | Bottom plate thickness | Model 4 mm; order 0.187in (4.75 mm). Extrude the extra 0.75 mm downward; drop the 1 mm shims.
8 | Gate thickness | Model 4 mm; SCS polycarbonate is 4.5 mm (0.177in).
9 | Add 8 corner brackets under the roof top bars
10 | Junction box size | Upsize to ~250 x 200 x 100 and keep the gland row at the same height, or accept a cramped 2-layer build.
11 | Screw lengths changed | Chute bracket M5x10 (not 12), light ring M5x8 (not 10), perch M5x25 flanged (not 30): the longer ones hit the extrusion core.
12 | Perch rod | 1-1/4in (31.75 mm) dowel, not a 1-5/16in closet pole.
13 | Generic 2028 brackets | 2 mm bigger than the modeled McMaster ones: check the bay-floor corner notches (1 mm clearance).
14 | Reward window height | 50 mm stroke -> 44 mm tall window. 100 mm stroke actuators would open it fully.
15 | Anchor the box | ~1.9 m tall on 2x2 legs.
16 | Tiny panel overlaps (ignore) | Left and back panels overlap the posts by 0.026 mm (frame posts are offset 0.074 mm). Not real.
