DylanCrooks/crowbox/(commit log)

2026-06-18 Add AI generated README for CrowBox firmware
    Added detailed project plans for CrowBox firmware, including functionality, hardware components, firmware architecture, project structure, current status, build instructions, roadmap, and hardware notes.
2026-06-20 fix gitignore, ignore vscode local history, add kicad power cluster
    [crowbox_kicad.kicad_pcb, crowbox_kicad.kicad_sch]
2026-06-20 emptied hardware folder, will do kicad on computer, won't be version controlled
    [crowbox_kicad.kicad_pcb, crowbox_kicad.kicad_sch]
2026-06-22 updated pinout.md power domains, clarified what each rail does
2026-06-23 moved actuators onto GPIOB on MCP23017, updated pinout and KiCad
2026-06-23 redid pin layout, updated kicad and pinout.md and pinout.h, moved LED pins
2026-06-27 updated partslist, still need 12V 2A wall adapter, solenoid lock, light strip, and one more linear actuator
2026-06-28 testing esp32, turning gpio2 on and off loop
2026-06-28 updated stages and such, added new files for each module
2026-06-28 phase 0 done, LED blinking on esp32
2026-07-04 updated ledc_timer stuff (1 for buzzer, 0 for servos)
    [buzzer.c, main.c, servo.c]
2026-07-05 gate,servo,solenoid.c have function declarations.
2026-07-07 did weight.c (functions for weighing hx711), also updated claude.md and claude.local.md so claude won't write code for me anymore, only answer questions after testing my knowledge first
    [weight.c, weight.h]
2026-07-13 wrote drivers, doing mcp23017 test w/ LEDs
2026-07-16 tested buzzer, LEDss, MCP23017, mg996r, solenoid circuit, buck converter 5V
    [main.c, mcp23017.c, mcp23017.h, servo.c, solenoid.c]
2026-08-02 state machine skeleton, weight driver, gate/solenoid drivers, logging stubs
    - crowbox.h: refactored to 12 states, added DEPOSIT_WEIGHT_BASELINE event type
    - state_machine.c: event dispatch loop, transition_to/state_name helpers, handler stubs; handle_pir_tripped opens gate per stage config
    - gate.c/h: implemented open/close/stop via MCP23017, added gate_is_open() state getter
    - solenoid.c/h: implemented unlock/lock via MCP23017, added solenoid_is_locked() state getter
    - weight.c/h: HX711 deposit polling task with 10-item circular buffer; variance-based settle detection; posts DETECTED/SETTLED/BASELINE events with one-shot flags; weight_reward_tray_is_empty() for on-demand reward chamber chec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
2026-08-05 wire state machine, config persistence, and sensor drivers to event bus
    - config.c/h: rewrote with NVS persistence (deposit count + stage),
    STAGE_CONFIGS table, config_on_deposit_success() with auto-advance logic
    - state_machine.c: implemented all handlers (pir_tripped, pir_cleared,
    deposit_weight_detected/settled, object_valid/invalid); fixed missing ()
    on all function calls, = vs == in conditions, gate_is_open() pointer bug;
    replaced raw NVS block in handle_object_valid with config_on_deposit_success()
    - weight.c: circular buffer with variance-based settle detection; one-shot
    posting flags for settled/detected/baseline events; reward chamber checked
    on-demand via weight_reward_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
2026-10-18 Switch vision to ESP32-P4, add gate homing, update hardware docs
    Firmware:
    - gate: add gate_home(), which drives both actuators in the retract
    direction for 12 s at startup so the gate always starts closed;
    raise GATE_TRAVEL_TICKS to 10 s. main.c calls gate_home() after
    mcp23017_init().
    - state_machine: add default cases to the switch statements and fix
    the int64_t log format (%lld).
    - CMake: glob only *.c in src/ and declare the ESP-IDF components it
    requires (nvs_flash, esp_system, driver, esp_timer).
    - pinout.h: move hopper 2's servo from GPIO14 to GPIO19 (GPIO14 outputs
    a signal at boot and would twitch the servo); reserve GPIO14 for
    hopper 4, which is out of the current bu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
2026-10-18 Add ESP32-P4 vision project skeleton (ESP-IDF v5.5.6)
    - vision/: separate ESP-IDF project for the Waveshare ESP32-P4-NANO
    vision coprocessor, created with idf.py create-project and targeted
    at esp32p4. Builds with ESP-IDF v5.5.6 (installed standalone at
    C:\esp\v5.5.6\esp-idf, not PlatformIO's copy).
    - vision/main/: empty module files, each with a one-line purpose
    comment: main.c (empty app_main), link (UART protocol, vision side),
    camera, storage (safe JPEG writes to microSD), preprocess, classify.h
    (one interface), classify_blob.c (classic CV, no ESP-IDF code so it
    tests on a laptop) and classify_model.cpp (ESP-DL is C++).
    - shared/vision_protocol.h: empty; will hold the messa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
2026-10-19 Vision board pipeline: UART link, camera, SD storage, blob classifier
    - shared/: vision link wire protocol (fixed 6-byte frames, CRC-8/SMBUS),
    compiled into both firmwares, with a laptop test
    - vision/ (ESP32-P4): link task + job queue, OV5647 capture through
    esp_video, JPEG to SD (temp file, fsync, rename), grayscale
    preprocessing, classic-CV blob classifier with a laptop test, model
    classifier stub
    - main firmware: vision_link UART driver; classify_object() asks the
    vision board and falls back to weight-only; chamber light on during
    visits; reference photo after the trapdoor clears
    - vision config: 16MB flash, custom partition table, PSRAM, FAT long
    filenames on heap, OV5647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
2026-10-21 Vision: trained-model classifier, training toolchain, deep sleep
    - vision/training: Python 3.12 venv toolchain (sort_photos, train,
    quantize, smoke_test). MobileNetV2 transfer learning -> int8 .espdl via
    ESP-PPQ; equalization off + TQT on (smoke test: int8 67% -> 100%)
    - classify_model.cpp: ESP-DL loads /sdcard/model.espdl if present, else
    the blob classifier runs; deploy/rollback is one file on the SD card
    - vision.c: results.csv log per photo; reference photos saved as known
    "none" examples
    - Deep sleep: MSG_SLEEP over the link; P4 sleeps after finishing its
    current job and wakes on its UART RX line (EXT1, ANY_LOW). Main board
    sends MSG_SLEEP before its own sleep and a wake PIN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
